FelixLee43/Mechatronic-2023/0713调研报告/Images/麦克纳姆轮.png

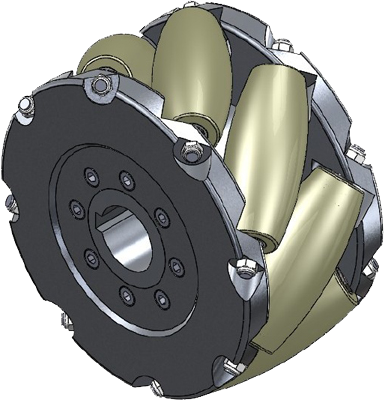
0713调研报告/Images/麦克纳姆轮.png
