FelixLee43/Mechatronic-2023/README.md

# 机电系统设计实践 第8组

> 许瀵译，李昊阳，贺则凡

任务展板：`https://kdocs.cn/l/ckOISye3qsVi`
