FelixLee43/Mechatronic-2023/0713调研报告/Images/绘图.pptx

开始

生成初始种群

计算个体适应度

变异操作

是否满足迭
代终止条件

交叉操作

否

选择操作

是

末代种群

最优个体

结束

## Slide 2

开始

初始化种群

适应度评
估和排序

使用改进轮盘
堵法选择个体

得
到
新
一
代
种
群

使用自适应概率
执行变异操作

是否满足迭
代终止条件

得到最优路径

否

是

结束

## Slide 3

开始

初始化粒子群中各
粒子的位置和速度

计算粒子的适应度值

求出每个粒子的个体最优

求出全部粒子的全局最优

更新粒子的速度和位置

是否满足迭
代终止条件

输出适应度
值最优个体

结束

否

是

## Slide 4

障碍

目标

引力

斥力

小
车

合力
