FelixLee43/Mechatronic-2023/0712课堂展示/Images/1.png

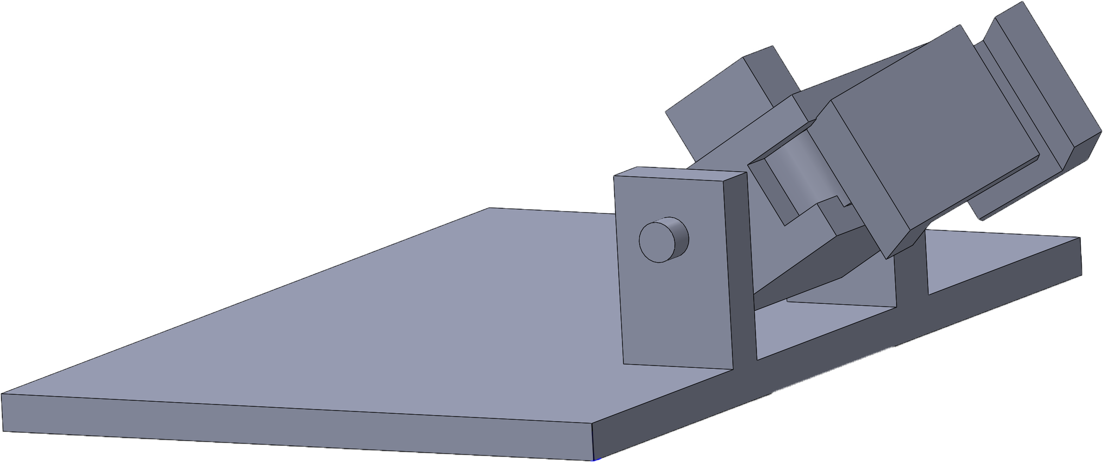
0712课堂展示/Images/1.png
