FelixLee43/Mechatronic-2023/0712课堂展示/Images/2.png

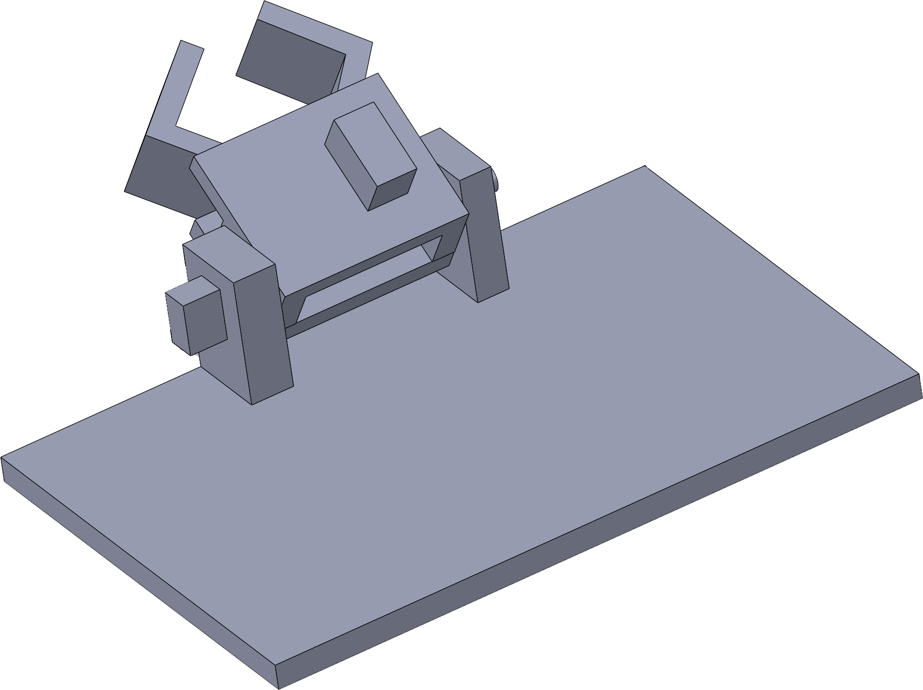
0712课堂展示/Images/2.png
