FelixLee43/Mechatronic-2023/0712课堂展示/Images/DJI Action 2 特写.jpg

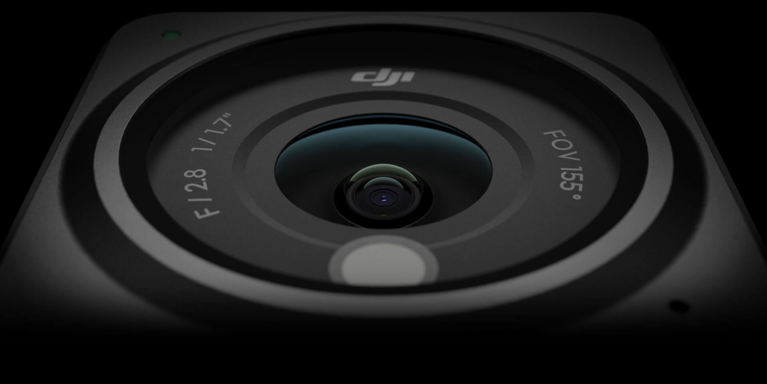
0712课堂展示/Images/DJI Action 2 特写.jpg
