FelixLee43/Mechatronic-2023/0712课堂展示/Images/openmv.png

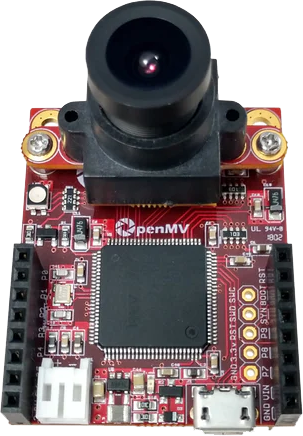
0712课堂展示/Images/openmv.png
