FelixLee43/Mechatronic-2023/机电系统设计实践_张佳悦_2022/作业/第三组智能小车/智能小车3D模型/L298N/L298N Stepper Motor Driver (Red).10.jpg

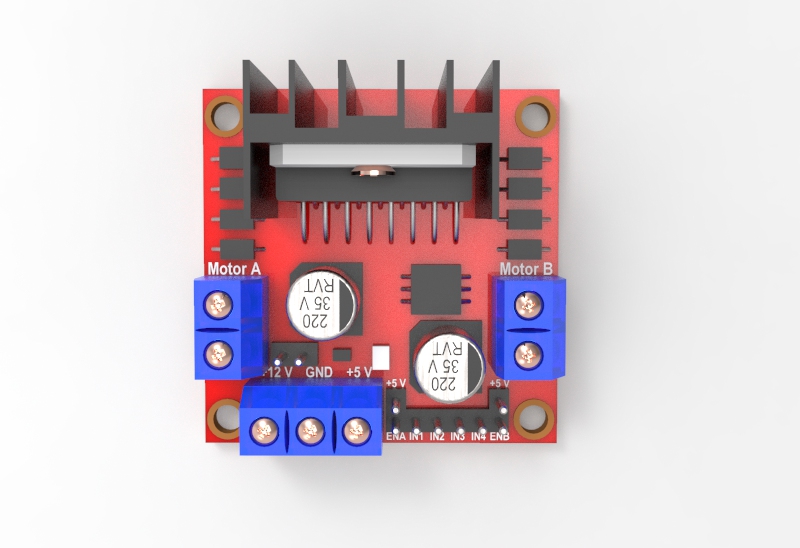
机电系统设计实践_张佳悦_2022/作业/第三组智能小车/智能小车3D模型/L298N/L298N Stepper Motor Driver (Red).10.jpg
