FelixLee43/Mechatronic-2023/机电系统设计实践_张佳悦_2022/作业/第三组智能小车/智能小车3D模型/SG90/Tower Pro 9g Micro Servo SG9 side.JPG

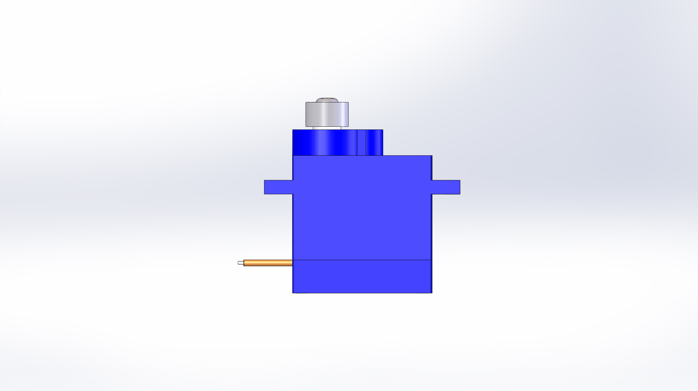
机电系统设计实践_张佳悦_2022/作业/第三组智能小车/智能小车3D模型/SG90/Tower Pro 9g Micro Servo SG9 side.JPG
