FelixLee43/Mechatronic-2023/机电系统设计实践_张佳悦_2022/作业/第三组智能小车/电气原理图（最终）.jpg

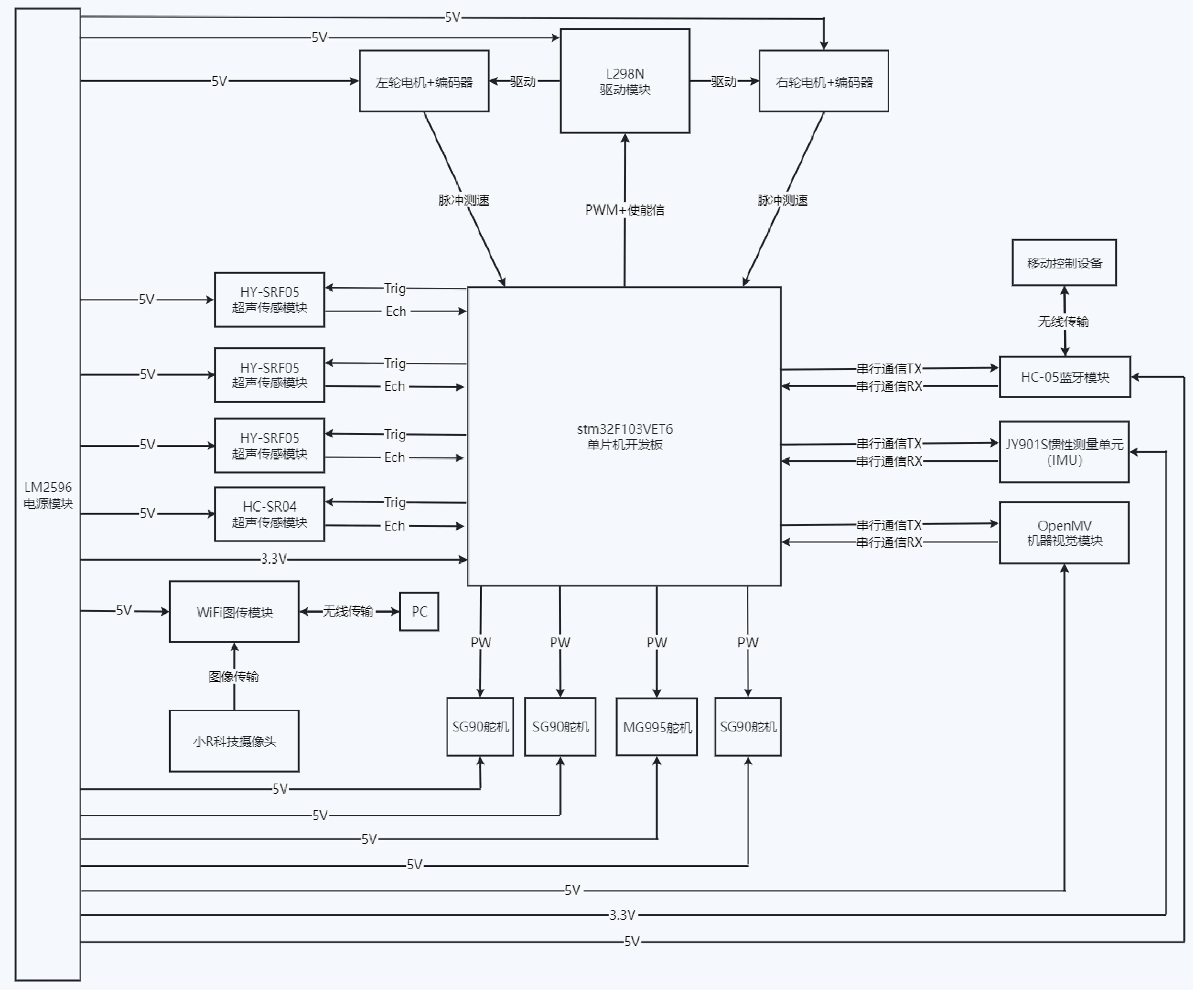
机电系统设计实践_张佳悦_2022/作业/第三组智能小车/电气原理图（最终）.jpg
