FelixLee43/Mechatronic-2023/机电系统设计实践_张佳悦_2022/作业/第三组详细设计/巡线软件.jpg

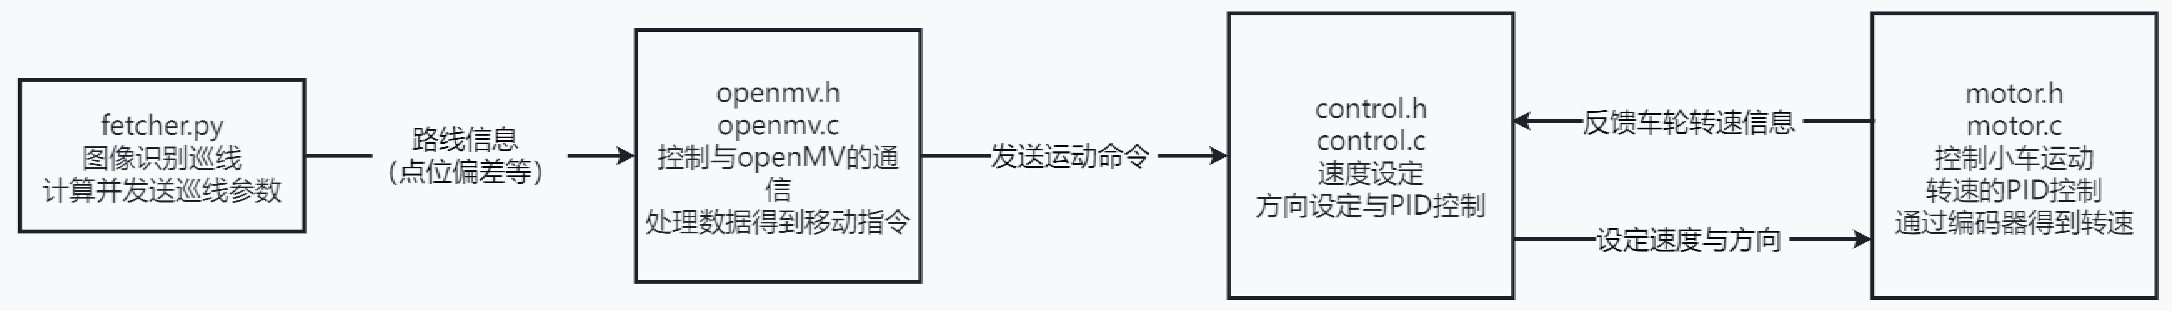
机电系统设计实践_张佳悦_2022/作业/第三组详细设计/巡线软件.jpg
