FelixLee43/Mechatronic-2023/机电系统设计实践_张佳悦_2022/材料清单.xlsx

材料 |  | 采购网址
控制平台 | 树莓派4代B （+外壳，散热片，电源线，风扇，16G储存卡）
 | STM32F103VET6开发板 | https://detail.tmall.com/item.htm?spm=a230r.1.14.64.71247093qWLax0&id=553122064820&ns=1&abbucket=12
传感器 | openMV | https://item.taobao.com/item.htm?id=612497720394&ns=1&abbucket=18
 | 激光雷达 | http://www.alsrobot.com.cn/goods-640.html
 | JY901S九轴IMU磁场加速度陀螺仪大气压强模块 | https://detail.tmall.com/item.htm?id=598203013266&ns=1&abbucket=0&skuId=4169997421172
 | 线性CCD(90度镜头) | https://item.taobao.com/item.htm?id=20749708544&ns=1&abbucket=12 (https://item.taobao.com/item.htm?spm=a230r.1.14.8.614e28fbKapafQ&id=20749708544&ns=1&abbucket=12)
 | HC-05蓝牙模块 | https://detail.tmall.com/item.htm?id=41327338424&rn=f2da8ad3bbef5681af64506ce8cc4ab0&abbucket=9
 | HC-SR04超声模块 | https://detail.tmall.com/item.htm?id=14466195609&ns=1&abbucket=12&skuId=3108214440220
执行器 | MG995 55G金属铜齿轮舵机 | https://item.taobao.com/item.htm?spm=a1z09.2.0.0.hFiM7A&id=530499783252&_u=bk64iil2e64
 | SG90 9G180度舵机 | https://item.taobao.com/item.htm?spm=a1z09.2.0.0.hFiM7A&id=528726113590&_u=bk64iil42c8
 | 直流减速电机带编码器1（12V，280rpm） | https://item.taobao.com/item.htm?id=533000737918&ns=1&abbucket=20 (https://item.taobao.com/item.htm?spm=a230r.1.14.13.466651825vUDDT&id=533000737918&ns=1&abbucket=20)
 | 直流减速电机带编码器2(12V,1:19减速比) | https://item.taobao.com/item.htm?spm=2013.1.w4004-10302371007.16.429c39e911jBcm&id=559699663497
 | L298N电机驱动板模块 | https://detail.tmall.com/item.htm?id=41248562401&ns=1&abbucket=12&skuId=4114388729372
 | ST-Link-V2 | https://detail.tmall.com/item.htm?id=521735720322&rn=fb11b15e9c6066752406e3460974b152&abbucket=9
 | USB转串口 | https://detail.tmall.com/item.htm?id=20601680359&spm=a1z09.2.0.0.UfbUKk&_u=bk64iilb651
 | 软串线 | 配套
车体 | 车轮+支架+联轴器 | 配套直流电机
电池 | 电池组 | 中发采购
 | 电源模块 | https://item.taobao.com/item.htm?_u=42fomaq693ee&id=16606969730
