FelixLee43/Mechatronic-2023/机电系统设计实践_张佳悦_2022/作业/第三组智能小车/智能小车3D模型/MG995/egrane2latonpin.SLDPRT.SLDASM

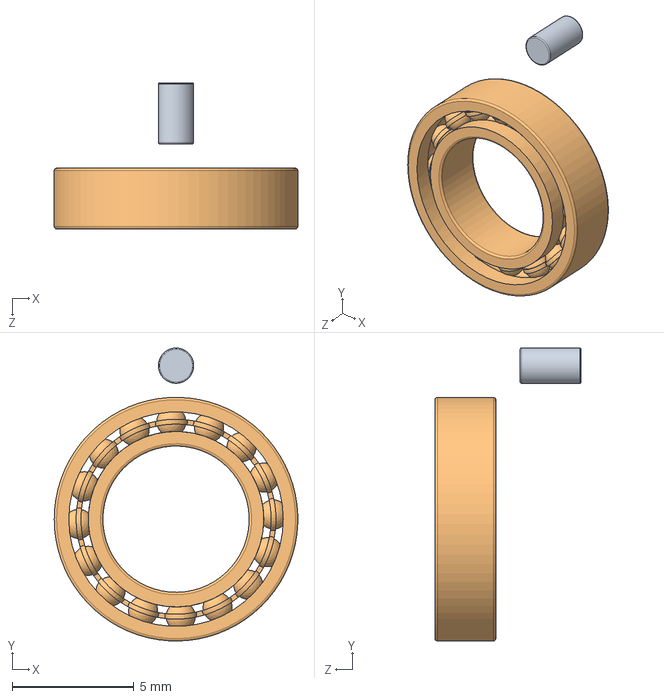
[picture p129: CAD file, 2023-07-10]
机电系统设计实践_张佳悦_2022/作业/第三组智能小车/智能小车3D模型/MG995/egrane2latonpin.SLDPRT.SLDASM
10.00 x 12.0 x 6.00 mm
egrane2latonpin
radial ball bearing_68_am
