FelixLee43/Mechatronic-2023/机电系统设计实践_张佳悦_2022/作业/第三组详细设计/智能小车3D模型/车轮/车轮部分.SLDASM

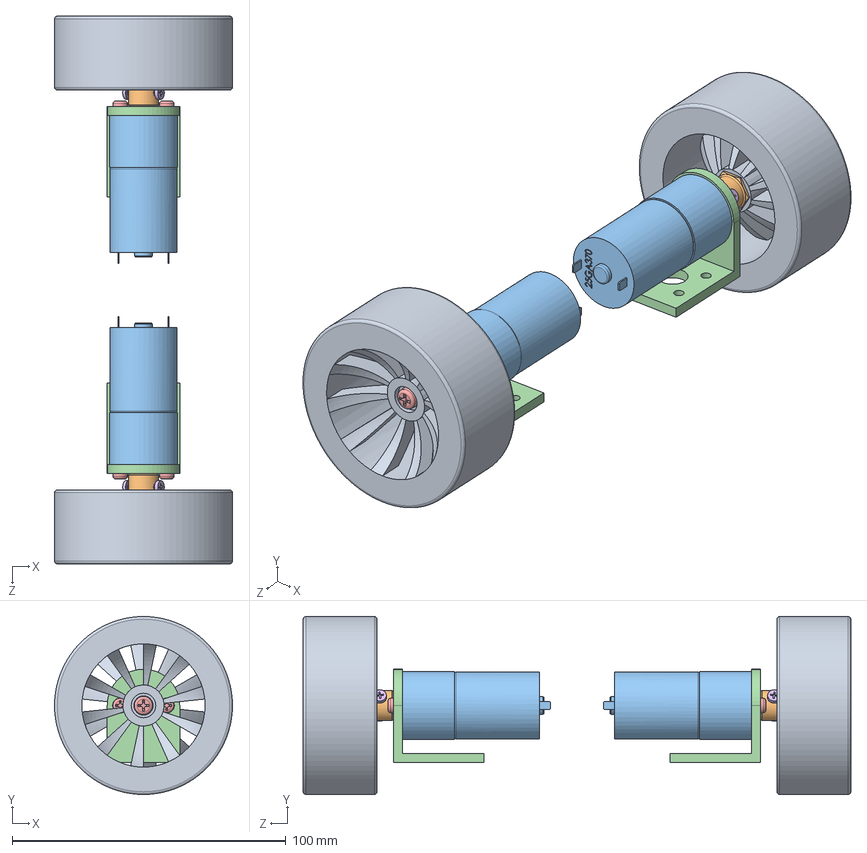
[picture p130: CAD file, 2023-07-10]
机电系统设计实践_张佳悦_2022/作业/第三组详细设计/智能小车3D模型/车轮/车轮部分.SLDASM
65.0 x 65.0 x 200.0 mm
橡胶车轮 x 2
内六角联轴器 x 2
25GA370 x 2
25GA370支撑架 x 2
cross recessed cheese head screws gb x 6
cross recessed cheese head screws type a gb x 4
