FelixLee43/Mechatronic-2023/智能小车/牛眼轮/牛眼轮.SLDASM

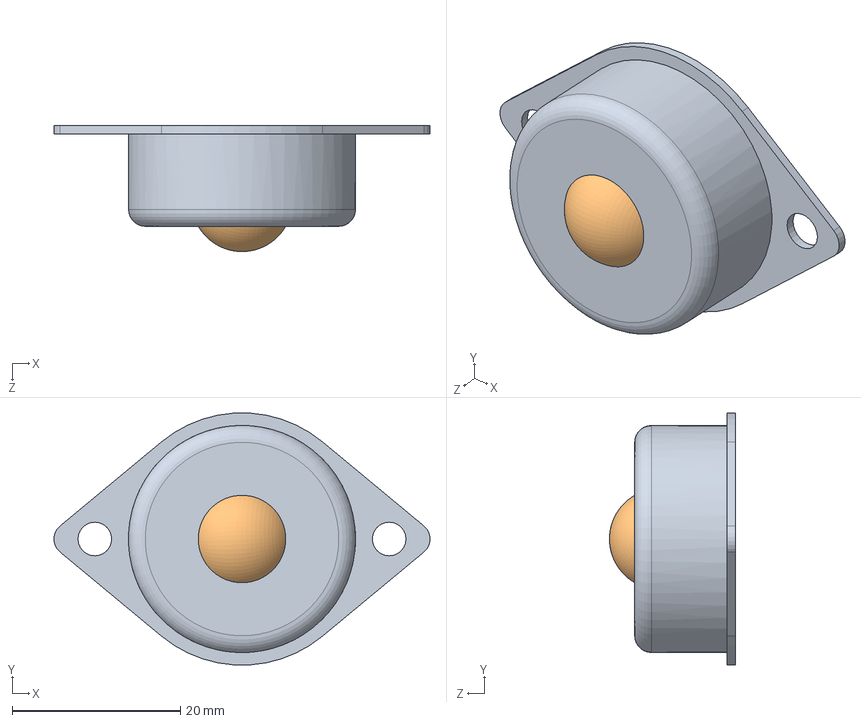
[picture p131: CAD file, 2023-07-15]
智能小车/牛眼轮/牛眼轮.SLDASM
44.7 x 29.9 x 15.0 mm
牛眼轮框
牛眼轮心
