FelixLee43/Mechatronic-2023/机电系统设计实践_张佳悦_2022/作业/第三组详细设计/智能小车3D模型/L298N/L298N.SLDASM

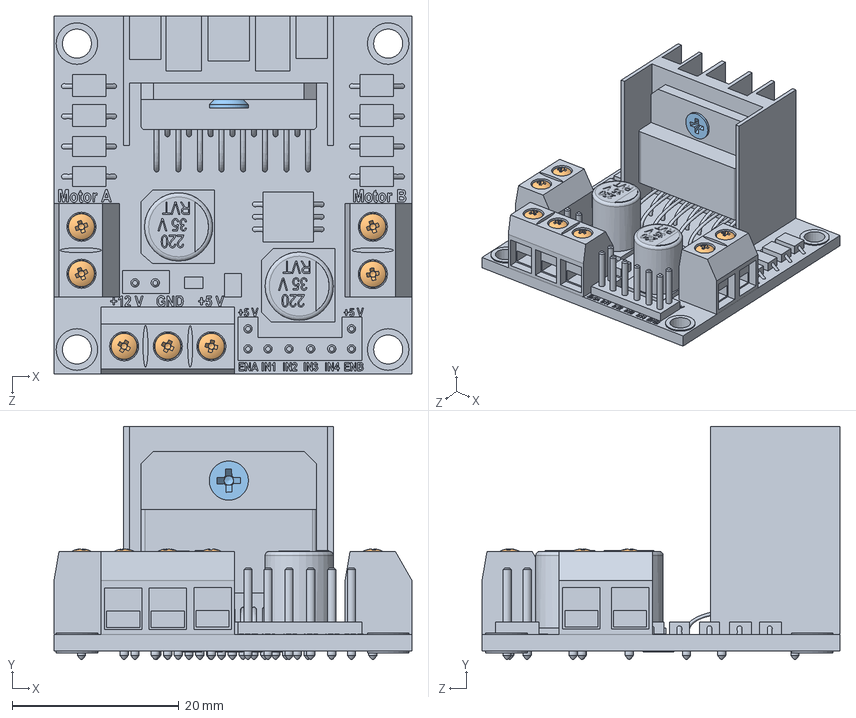
[picture p132: CAD file, 2023-07-10]
机电系统设计实践_张佳悦_2022/作业/第三组详细设计/智能小车3D模型/L298N/L298N.SLDASM
43.0 x 28.0 x 43.0 mm
L298N Stepper Motor Driver (Red)
pan head cross recess screw_iso x 7
countersunk flat head cross recess screw_iso
