FelixLee43/Mechatronic-2023/机电系统设计实践_张佳悦_2022/作业/第三组智能小车/智能小车3D模型/SG90/SG90.SLDASM

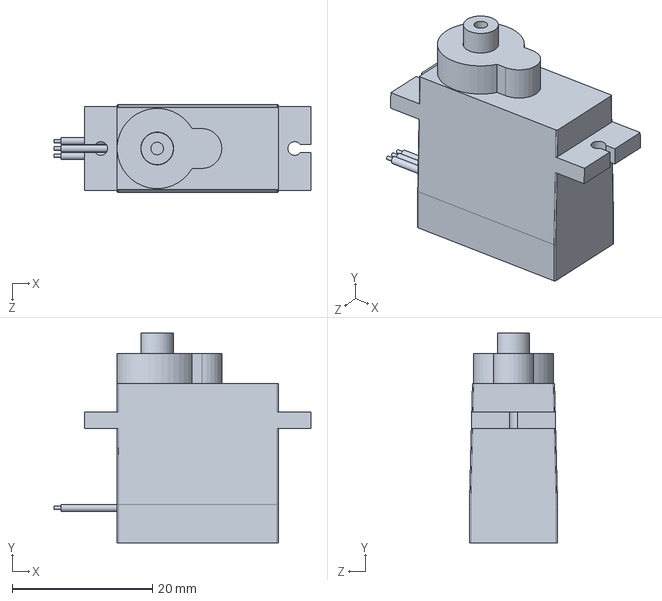
[picture p133: CAD file, 2023-07-10]
机电系统设计实践_张佳悦_2022/作业/第三组智能小车/智能小车3D模型/SG90/SG90.SLDASM
36.7 x 30.0 x 12.6 mm
