FelixLee43/Mechatronic-2023/机电系统设计实践_张佳悦_2022/作业/第三组详细设计/智能小车3D模型/机械臂/机械臂.SLDASM

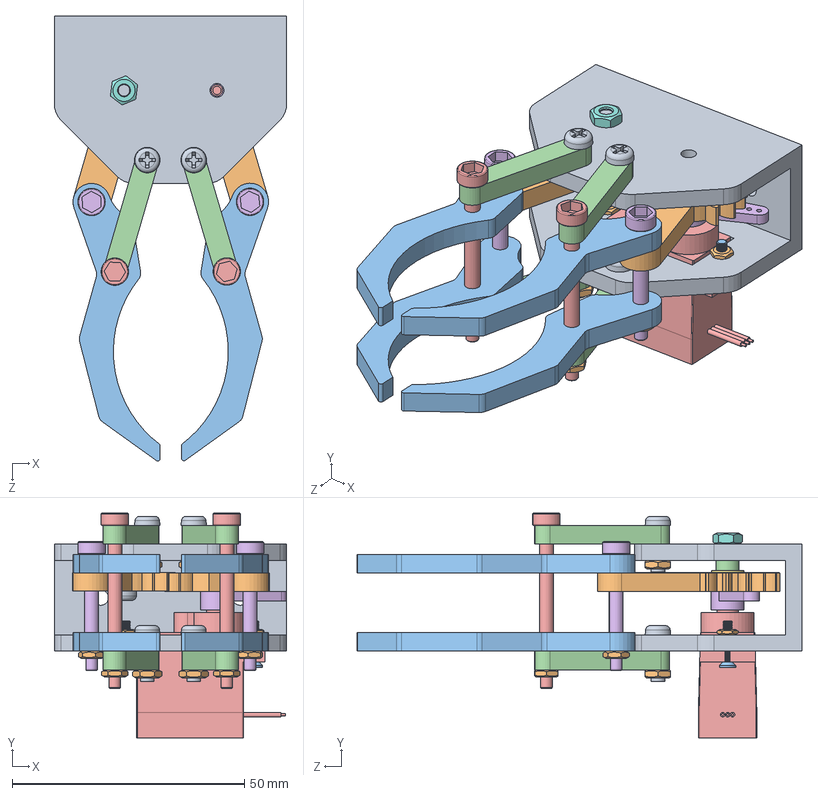
[picture p134: CAD file, 2023-07-10]
机电系统设计实践_张佳悦_2022/作业/第三组详细设计/智能小车3D模型/机械臂/机械臂.SLDASM
50.0 x 48.4 x 95.7 mm
支撑板（改）
齿轮传动杆 x 2
机械手爪（改） x 4
连杆（改） x 4
Tower Pro 9g Micro Servo SG90
SG90 plastic Horn
plain washers--product grade c gb
hex nuts, style 1-grades ab gb
cross recessed cheese head screws gb x 5
hex thin nuts-grades ab-chamfered gb x 10
cross recessed countersunk head screws gb2 x 2
2.1支撑垫片
30限位螺栓 x 2
20限位螺栓 x 2
