FelixLee43/Mechatronic-2023/机电系统设计实践_张佳悦_2022/作业/第三组详细设计/智能小车3D模型/MG995/tapa servorodamiento.SLDPRT.SLDASM

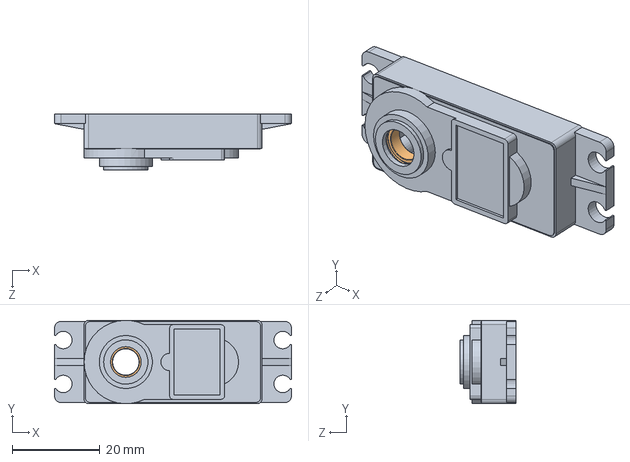
[picture p135: CAD file, 2023-07-10]
机电系统设计实践_张佳悦_2022/作业/第三组详细设计/智能小车3D模型/MG995/tapa servorodamiento.SLDPRT.SLDASM
54.0 x 19.0 x 12.8 mm
tapa servo
radial ball bearing_68_am
