FelixLee43/Mechatronic-2023/机电系统设计实践_张佳悦_2022/作业/第三组智能小车/智能小车3D模型/MG995/egrane4aluminiolaton.SLDPRT.SLDASM

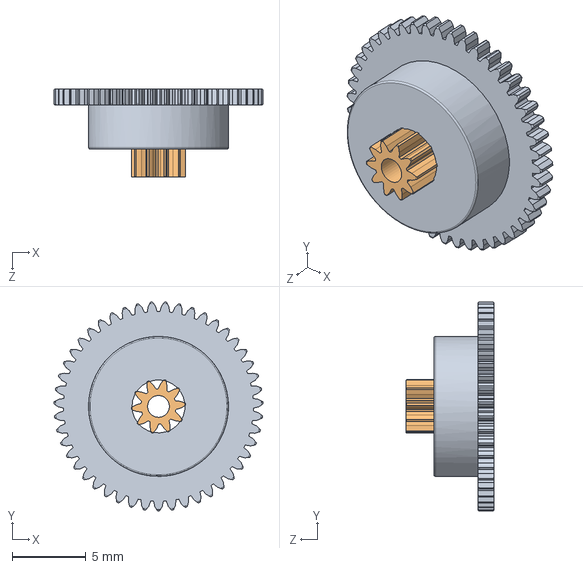
[picture p137: CAD file, 2023-07-10]
机电系统设计实践_张佳悦_2022/作业/第三组智能小车/智能小车3D模型/MG995/egrane4aluminiolaton.SLDPRT.SLDASM
14.2 x 14.2 x 6.00 mm
egrane4laton
egrane4aluminio
