FelixLee43/Mechatronic-2023/机电系统设计实践_张佳悦_2022/作业/第三组智能小车/智能小车3D模型/MG995/MG995.SLDASM

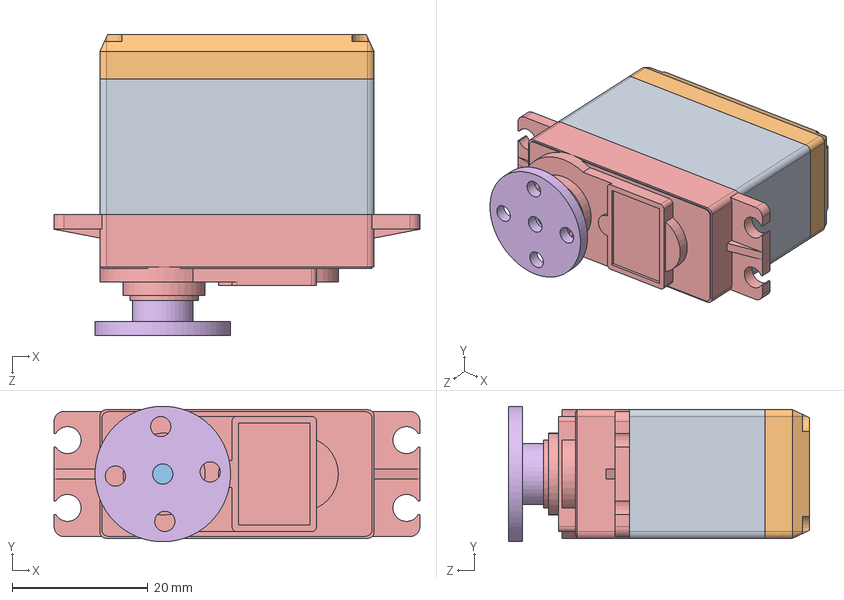
[picture p138: CAD file, 2023-07-10]
机电系统设计实践_张佳悦_2022/作业/第三组智能小车/智能小车3D模型/MG995/MG995.SLDASM
54.0 x 20.0 x 44.3 mm
centroservo
egrane3laton
egrane3aluminio
egrane4laton
egrane4aluminio
engrane2
pincorto
pinlargo
radial ball bearing_68_am x 2
baseservo
otro
egrane2latonpin
tapa servo
Bracket-Horn
