FelixLee43/Mechatronic-2023/机电系统设计实践_张佳悦_2022/作业/第三组详细设计/智能小车3D模型/OpenMV H7/openmv4_ov7725.SLDASM

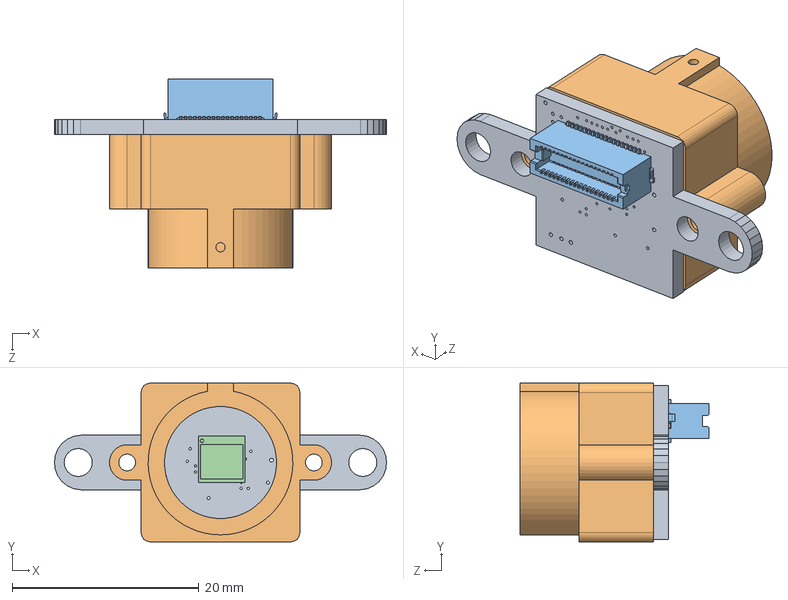
[picture p139: CAD file, 2023-07-10]
机电系统设计实践_张佳悦_2022/作业/第三组详细设计/智能小车3D模型/OpenMV H7/openmv4_ov7725.SLDASM
35.6 x 17.0 x 20.2 mm
ov7725
mount_lens
DF1236
CSP2-28
