FelixLee43/Mechatronic-2023/机电系统设计实践_张佳悦_2022/作业/第三组智能小车/智能小车3D模型/OpenMV H7/OpenMV H7.SLDASM

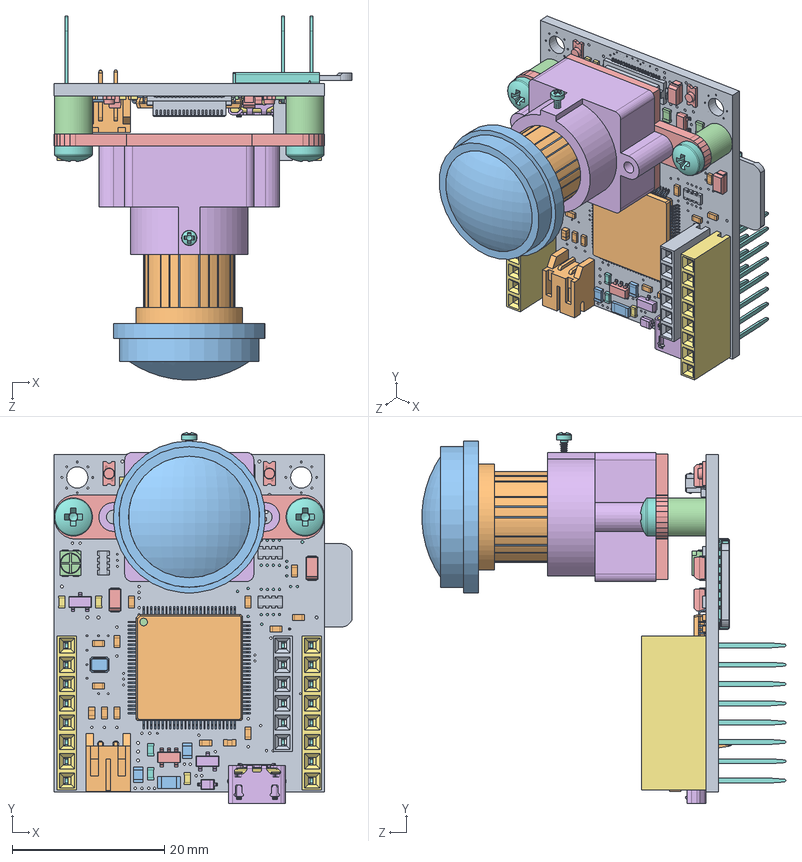
[picture p140: CAD file, 2023-07-10]
机电系统设计实践_张佳悦_2022/作业/第三组智能小车/智能小车3D模型/OpenMV H7/OpenMV H7.SLDASM
39.2 x 48.8 x 47.9 mm
base
C0603K_C0603K x 13
C0805K_C0805K x 2
cap3216h160 x 3
SOD323_BAT54HT1G
960240-6202-AR Body8 x 2
960240-6202-AR Pin Long x 22
960240-6202-AR Body6
Capacitor 0603 x 2
LED SMD RGB
LED 1206 IR x 2
SOT 23 x 2
Resistor 0603 x 5
R0603_SJR x 2
EXBV8V x 3
User Library-LQFP100-3_case
User Library-LQFP100-3_pin x 100
User Library-LQFP100-3_circle
SOT 23-5 x 2
UJ2-MIBH2-4-SMT_01
UJ2-MIBH2-4-SMT_02
1040310811_USD1040310811
DF12-36DS-0.5V
S2B-PH-K-S(LF)(SN)
Crystal-SM2520-4
Standoff metal 5x2.5mm x 2
ov7725
mount_lens
CSP2-28
pan head cross recess screw_iso x 3
microsd card
LENS_Standard
LENS_Wide
