FelixLee43/Mechatronic-2023/机电系统设计实践_张佳悦_2022/作业/第三组详细设计/智能小车3D模型/OpenMV H7/User Library-LQFP100-3.sldasm

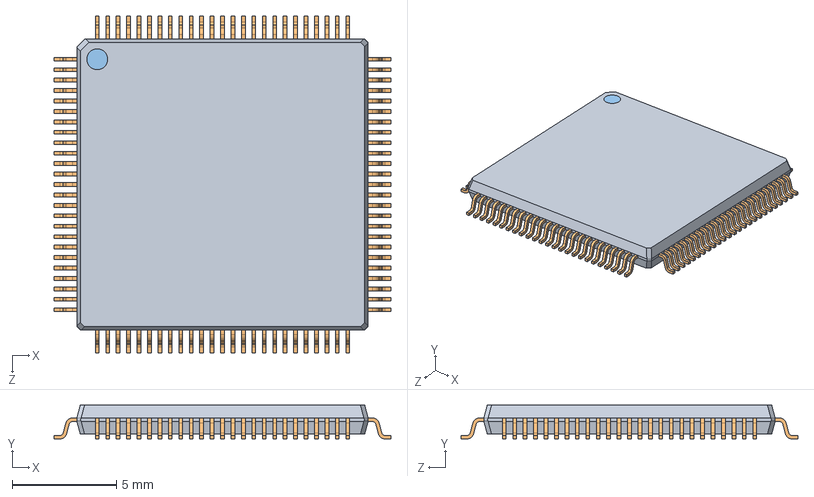
[picture p142: CAD file, 2023-07-10]
机电系统设计实践_张佳悦_2022/作业/第三组详细设计/智能小车3D模型/OpenMV H7/User Library-LQFP100-3.sldasm
16.1 x 1.63 x 16.1 mm
User Library-LQFP100-3_case
User Library-LQFP100-3_pin x 100
User Library-LQFP100-3_circle
