FelixLee43/Mechatronic-2023/机电系统设计实践_张佳悦_2022/作业/第三组详细设计/智能小车3D模型/OpenMV H7/UJ2-MIBH2-4-SMT.SLDASM

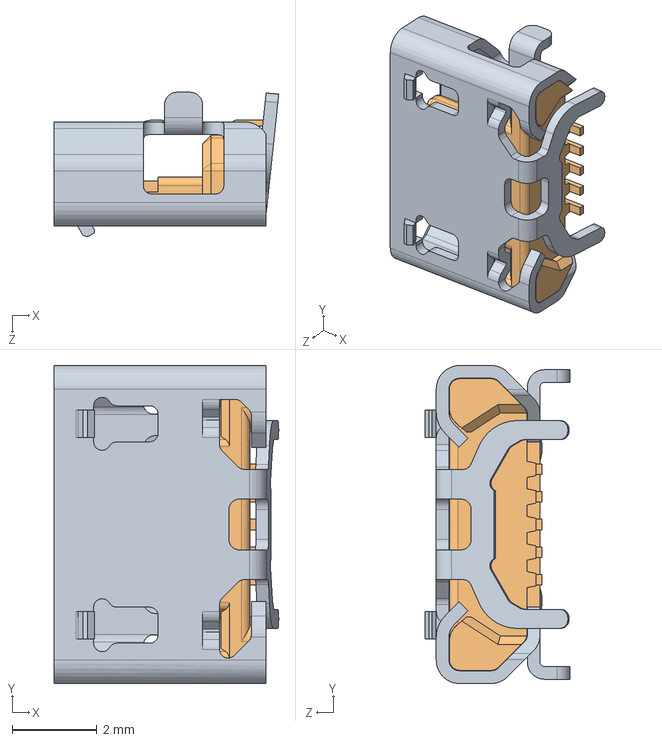
[picture p143: CAD file, 2023-07-10]
机电系统设计实践_张佳悦_2022/作业/第三组详细设计/智能小车3D模型/OpenMV H7/UJ2-MIBH2-4-SMT.SLDASM
5.29 x 7.50 x 3.41 mm
UJ2-MIBH2-4-SMT_01
UJ2-MIBH2-4-SMT_02
