FelixLee43/Mechatronic-2023/智能小车/二楼/二楼.SLDPRT

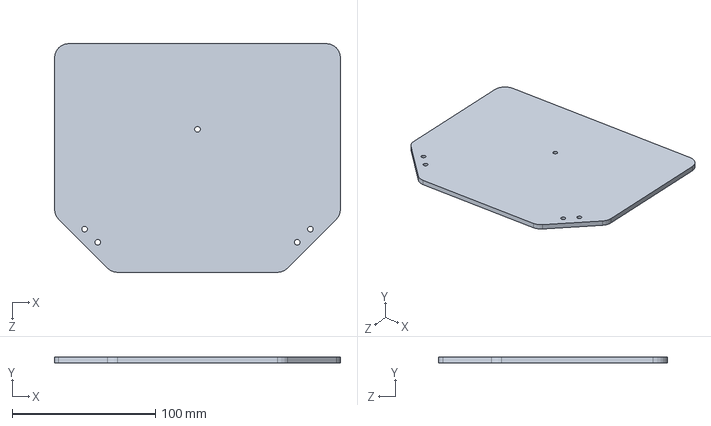
[picture p144: CAD file, 2023-07-15]
智能小车/二楼/二楼.SLDPRT
200.0 x 4.00 x 160.0 mm
