FelixLee43/Mechatronic-2023/智能小车/底板/底板.SLDPRT

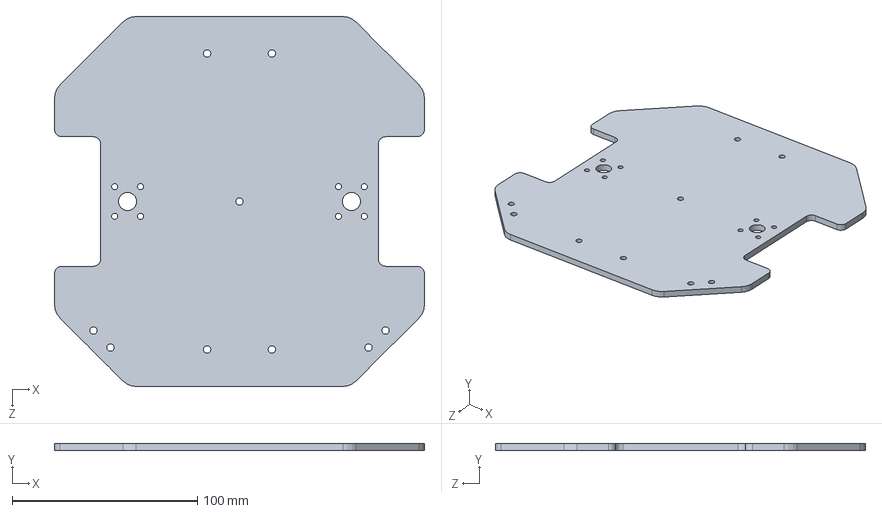
[picture p145: CAD file, 2023-07-15]
智能小车/底板/底板.SLDPRT
200.0 x 4.00 x 200.0 mm
