FelixLee43/Mechatronic-2023/智能小车/抓手/抓手齿轮盒.SLDPRT

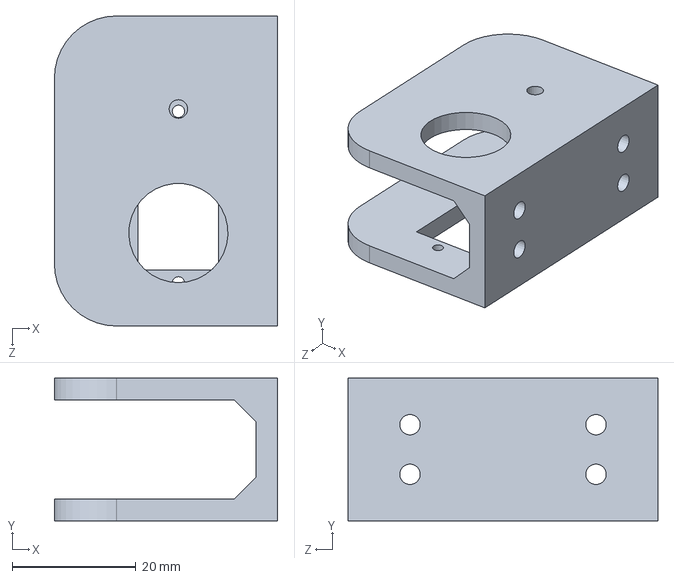
[picture p146: CAD file, 2023-07-15]
智能小车/抓手/抓手齿轮盒.SLDPRT
36.0 x 23.0 x 50.0 mm
