FelixLee43/Mechatronic-2023/智能小车/普通轮/电机.SLDPRT

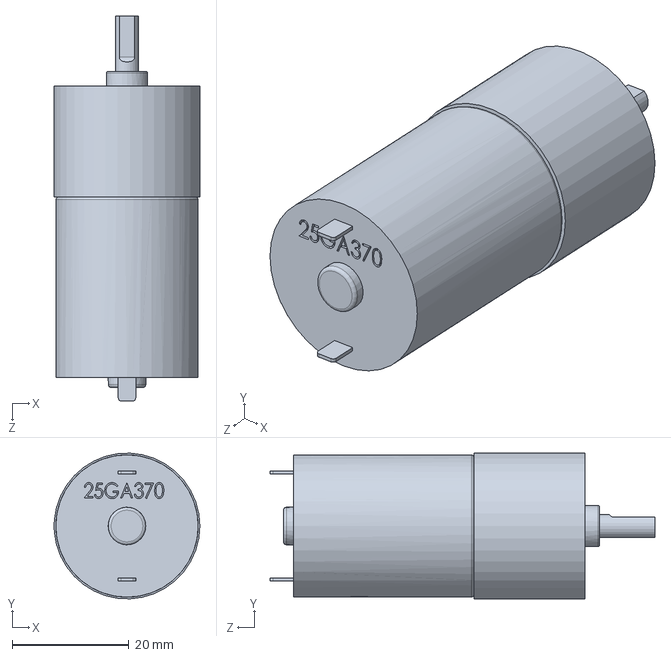
[picture p147: CAD file, 2023-07-15]
智能小车/普通轮/电机.SLDPRT
25.0 x 25.0 x 66.0 mm
