FelixLee43/Mechatronic-2023/智能小车/牛眼轮/牛眼轮心.SLDPRT

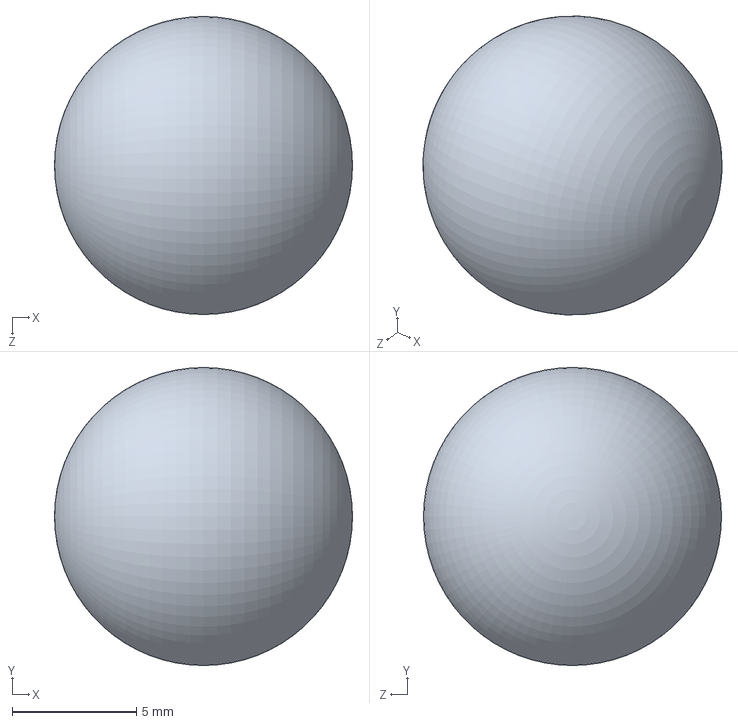
[picture p148: CAD file, 2023-07-15]
智能小车/牛眼轮/牛眼轮心.SLDPRT
12.0 x 12.0 x 12.0 mm
