FelixLee43/Mechatronic-2023/智能小车/超声/超声波探测器.SLDPRT

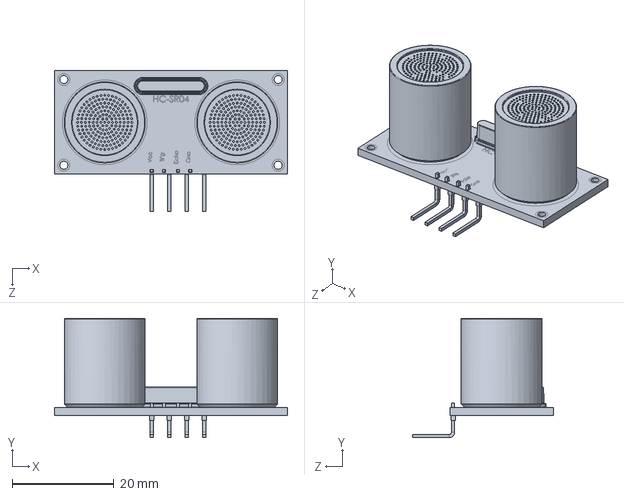
[picture p149: CAD file, 2023-07-15]
智能小车/超声/超声波探测器.SLDPRT
45.7 x 23.4 x 27.6 mm
