FelixLee43/Mechatronic-2023/机电系统设计实践_张佳悦_2022/作业/第三组智能小车/智能小车3D模型/OpenMV H7/EXBV8V.SLDPRT

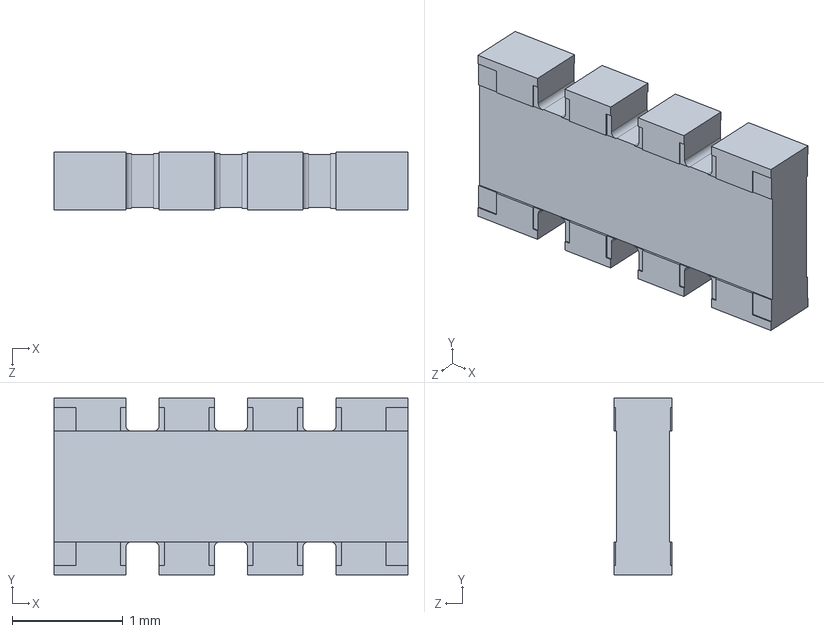
[picture p151: CAD file, 2023-07-10]
机电系统设计实践_张佳悦_2022/作业/第三组智能小车/智能小车3D模型/OpenMV H7/EXBV8V.SLDPRT
3.20 x 1.60 x 0.52 mm
