FelixLee43/Mechatronic-2023/机电系统设计实践_张佳悦_2022/作业/第三组智能小车/智能小车3D模型/二层三层连接件3.SLDPRT

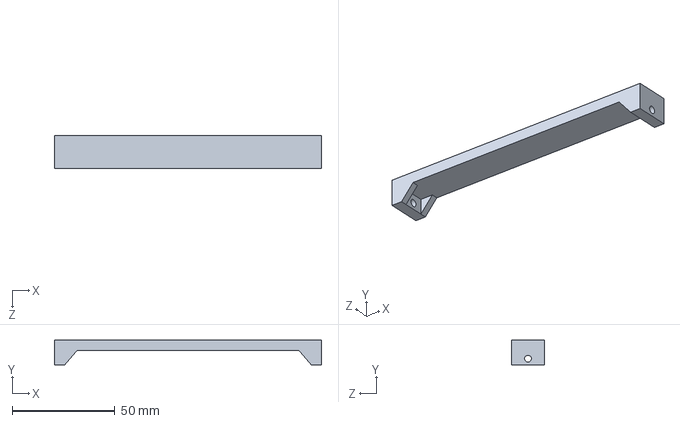
[picture p152: CAD file, 2023-07-10]
机电系统设计实践_张佳悦_2022/作业/第三组智能小车/智能小车3D模型/二层三层连接件3.SLDPRT
130.0 x 12.0 x 16.0 mm
