FelixLee43/Mechatronic-2023/机电系统设计实践_张佳悦_2022/作业/第三组智能小车/智能小车3D模型/机械臂/机械手爪（改）.SLDPRT

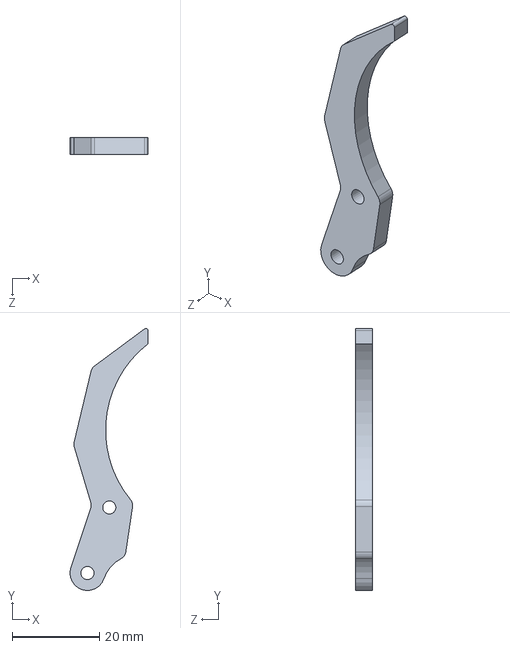
[picture p153: CAD file, 2023-07-10]
机电系统设计实践_张佳悦_2022/作业/第三组智能小车/智能小车3D模型/机械臂/机械手爪（改）.SLDPRT
17.8 x 59.9 x 4.00 mm
