FelixLee43/Mechatronic-2023/机电系统设计实践_张佳悦_2022/作业/第三组智能小车/智能小车3D模型/车轮/25GA370支撑架.SLDPRT

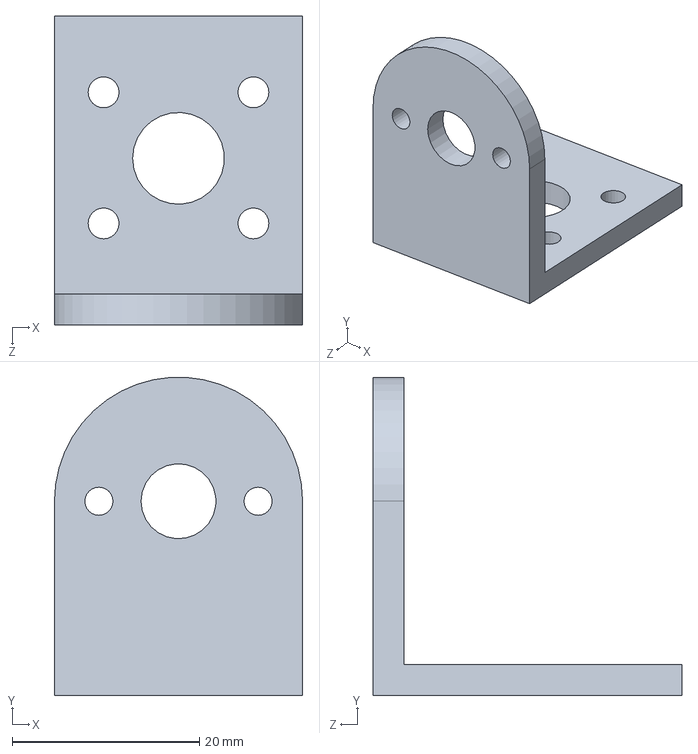
[picture p154: CAD file, 2023-07-10]
机电系统设计实践_张佳悦_2022/作业/第三组智能小车/智能小车3D模型/车轮/25GA370支撑架.SLDPRT
26.5 x 34.0 x 33.0 mm
