FelixLee43/Mechatronic-2023/机电系统设计实践_张佳悦_2022/作业/第三组详细设计/智能小车3D模型/HC-SR04支撑架（右前）新.SLDPRT

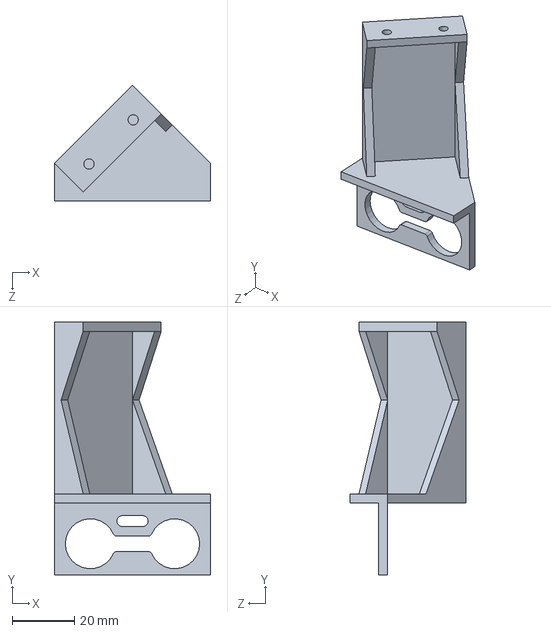
[picture p155: CAD file, 2023-07-10]
机电系统设计实践_张佳悦_2022/作业/第三组详细设计/智能小车3D模型/HC-SR04支撑架（右前）新.SLDPRT
50.0 x 81.0 x 37.0 mm
