FelixLee43/Mechatronic-2023/机电系统设计实践_张佳悦_2022/作业/第三组详细设计/智能小车3D模型/MG995/egrane3laton.SLDPRT

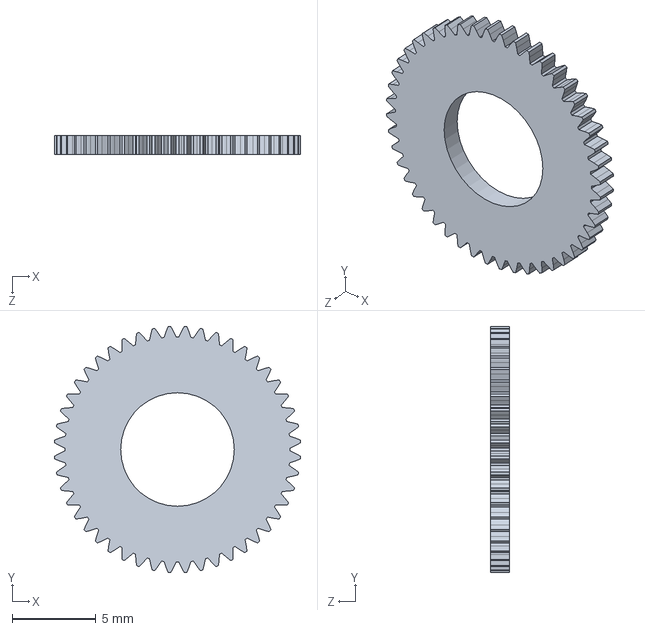
[picture p156: CAD file, 2023-07-10]
机电系统设计实践_张佳悦_2022/作业/第三组详细设计/智能小车3D模型/MG995/egrane3laton.SLDPRT
14.7 x 14.7 x 1.15 mm
