FelixLee43/Mechatronic-2023/智能小车/STM32单片机.SLDPRT

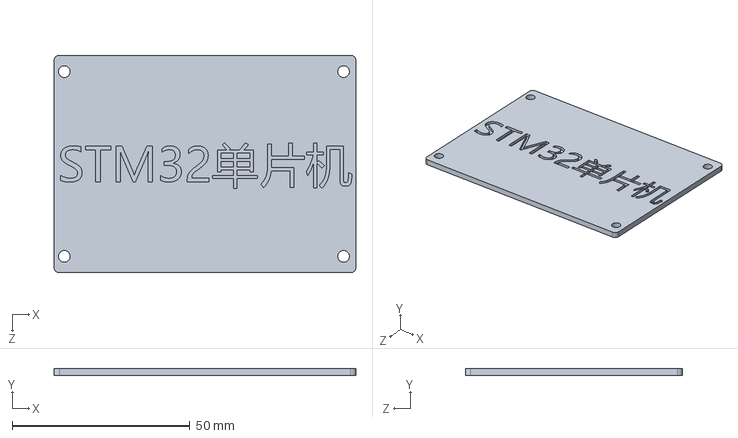
[picture p158: CAD file, 2023-07-15]
智能小车/STM32单片机.SLDPRT
85.0 x 2.00 x 61.2 mm
