FelixLee43/Mechatronic-2023/智能小车/二楼/二楼支撑柱.SLDPRT

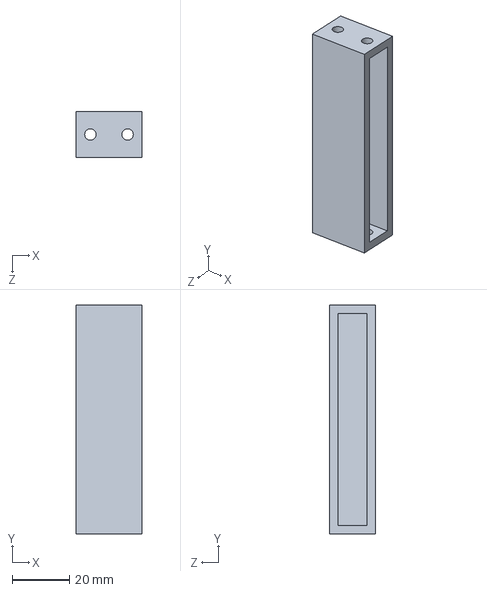
[picture p159: CAD file, 2023-07-15]
智能小车/二楼/二楼支撑柱.SLDPRT
23.0 x 80.0 x 16.0 mm
