FelixLee43/Mechatronic-2023/智能小车/抓手/俯仰部分右固定座.SLDPRT

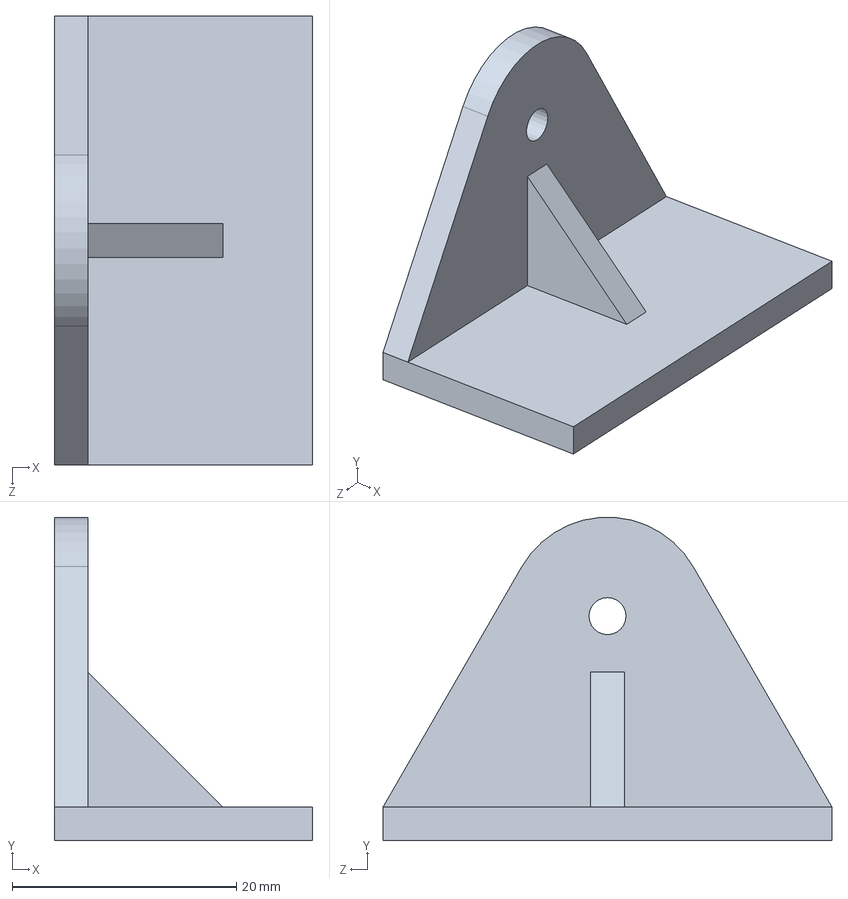
[picture p160: CAD file, 2023-07-15]
智能小车/抓手/俯仰部分右固定座.SLDPRT
23.0 x 28.8 x 40.0 mm
