FelixLee43/Mechatronic-2023/智能小车/超声/超声波探测器支架.SLDPRT

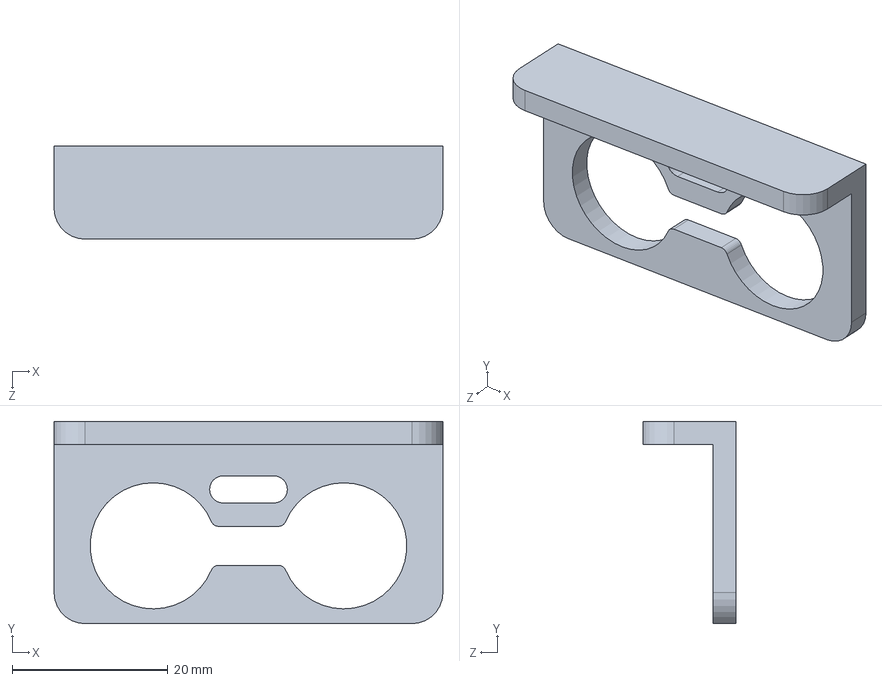
[picture p161: CAD file, 2023-07-15]
智能小车/超声/超声波探测器支架.SLDPRT
50.0 x 26.0 x 12.0 mm
