FelixLee43/Mechatronic-2023/机电系统设计实践_张佳悦_2022/作业/第三组智能小车/智能小车3D模型/MG995/Bracket-Horn.SLDPRT

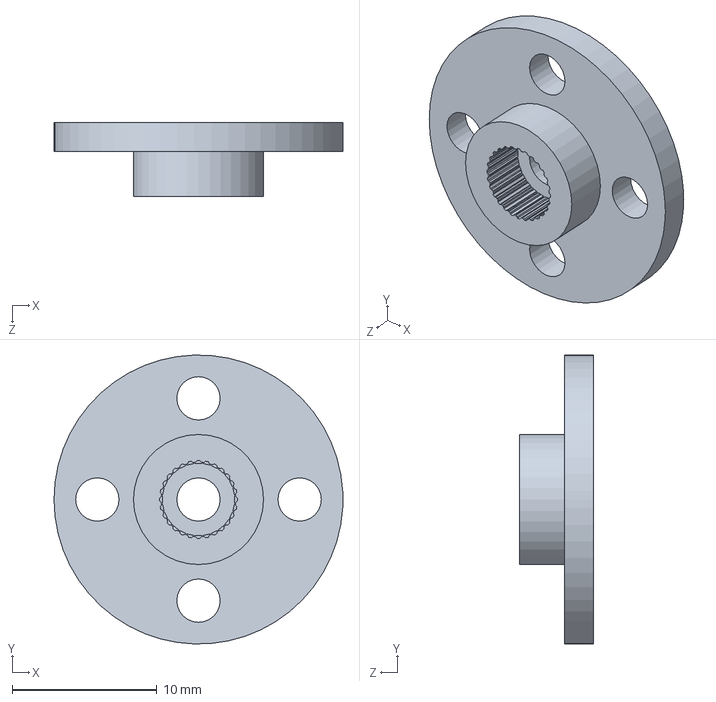
[picture p162: CAD file, 2023-07-10]
机电系统设计实践_张佳悦_2022/作业/第三组智能小车/智能小车3D模型/MG995/Bracket-Horn.SLDPRT
20.0 x 20.0 x 5.10 mm
