FelixLee43/Mechatronic-2023/机电系统设计实践_张佳悦_2022/作业/第三组智能小车/智能小车3D模型/SG90/SG90 plastic Horn.SLDPRT

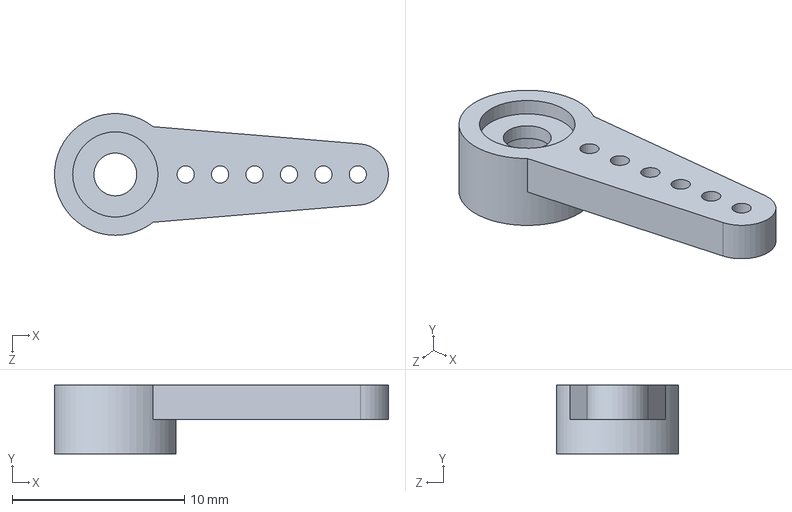
[picture p163: CAD file, 2023-07-10]
机电系统设计实践_张佳悦_2022/作业/第三组智能小车/智能小车3D模型/SG90/SG90 plastic Horn.SLDPRT
19.4 x 4.00 x 7.06 mm
