FelixLee43/Mechatronic-2023/机电系统设计实践_张佳悦_2022/作业/第三组详细设计/智能小车3D模型/OpenMV H7/DF12-36DS-0.5V.SLDPRT

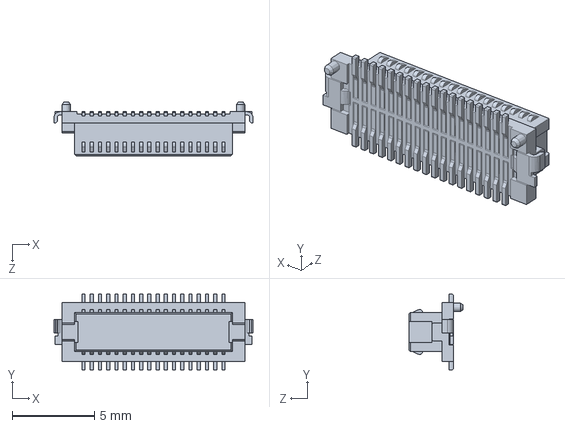
[picture p165: CAD file, 2023-07-10]
机电系统设计实践_张佳悦_2022/作业/第三组详细设计/智能小车3D模型/OpenMV H7/DF12-36DS-0.5V.SLDPRT
12.1 x 4.60 x 3.30 mm
