FelixLee43/Mechatronic-2023/机电系统设计实践_张佳悦_2022/作业/第三组详细设计/智能小车3D模型/一层二层连接件.SLDPRT

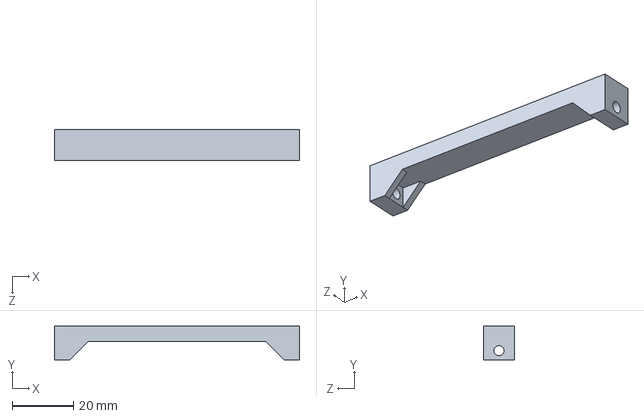
[picture p166: CAD file, 2023-07-10]
机电系统设计实践_张佳悦_2022/作业/第三组详细设计/智能小车3D模型/一层二层连接件.SLDPRT
80.0 x 11.0 x 10.0 mm
