FelixLee43/Mechatronic-2023/机电系统设计实践_张佳悦_2022/作业/第三组详细设计/智能小车3D模型/机械臂/20限位螺栓.SLDPRT

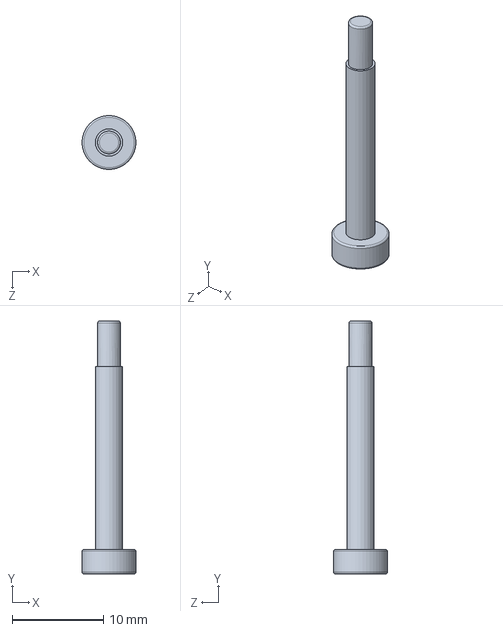
[picture p167: CAD file, 2023-07-10]
机电系统设计实践_张佳悦_2022/作业/第三组详细设计/智能小车3D模型/机械臂/20限位螺栓.SLDPRT
5.89 x 27.7 x 5.90 mm
