FelixLee43/Mechatronic-2023/机电系统设计实践_张佳悦_2022/作业/第三组详细设计/智能小车3D模型/车轮/内六角联轴器.SLDPRT

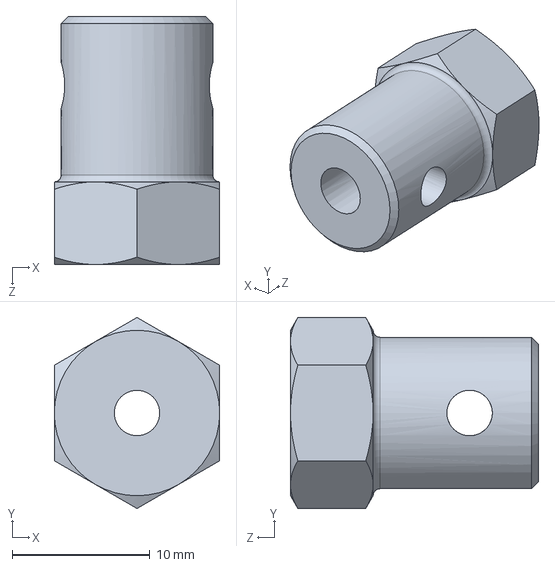
[picture p168: CAD file, 2023-07-10]
机电系统设计实践_张佳悦_2022/作业/第三组详细设计/智能小车3D模型/车轮/内六角联轴器.SLDPRT
12.0 x 13.9 x 18.0 mm
