FelixLee43/Mechatronic-2023/智能小车/抓手/俯仰部分.SLDPRT

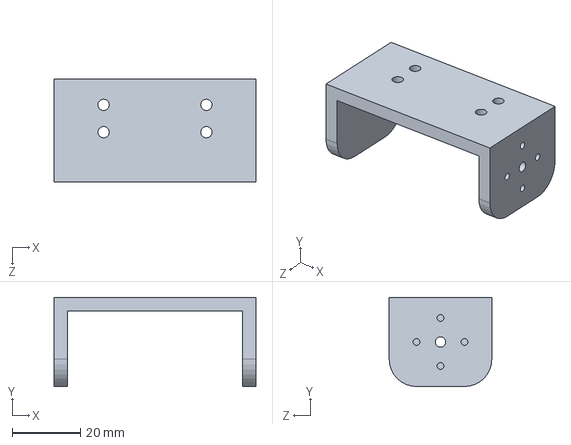
[picture p169: CAD file, 2023-07-15]
智能小车/抓手/俯仰部分.SLDPRT
59.0 x 26.0 x 30.0 mm
