FelixLee43/Mechatronic-2023/智能小车/普通轮/普通轮.SLDPRT

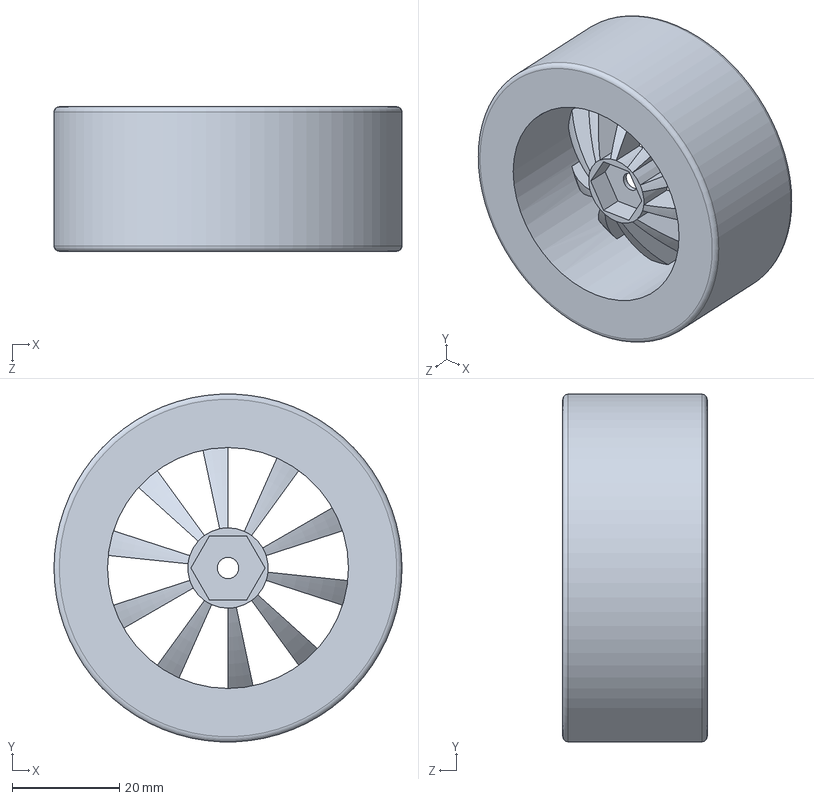
[picture p170: CAD file, 2023-07-15]
智能小车/普通轮/普通轮.SLDPRT
65.0 x 64.9 x 27.0 mm
