FelixLee43/Mechatronic-2023/智能小车/牛眼轮/牛眼轮框.SLDPRT

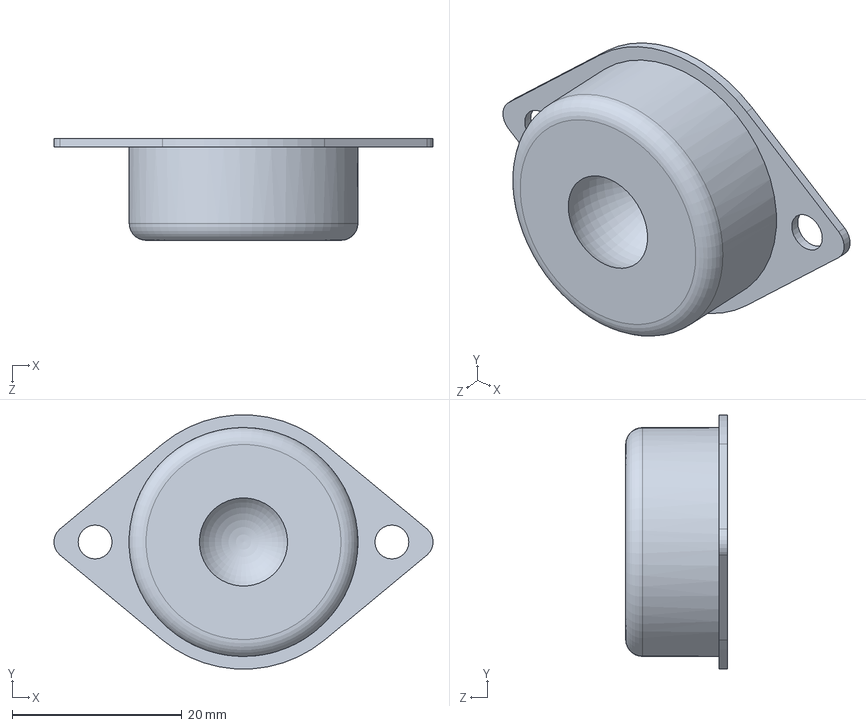
[picture p171: CAD file, 2023-07-15]
智能小车/牛眼轮/牛眼轮框.SLDPRT
44.7 x 29.9 x 12.0 mm
