FelixLee43/Mechatronic-2023/机电系统设计实践_张佳悦_2022/作业/第三组智能小车/智能小车3D模型/摄像头支撑架（改）.SLDPRT

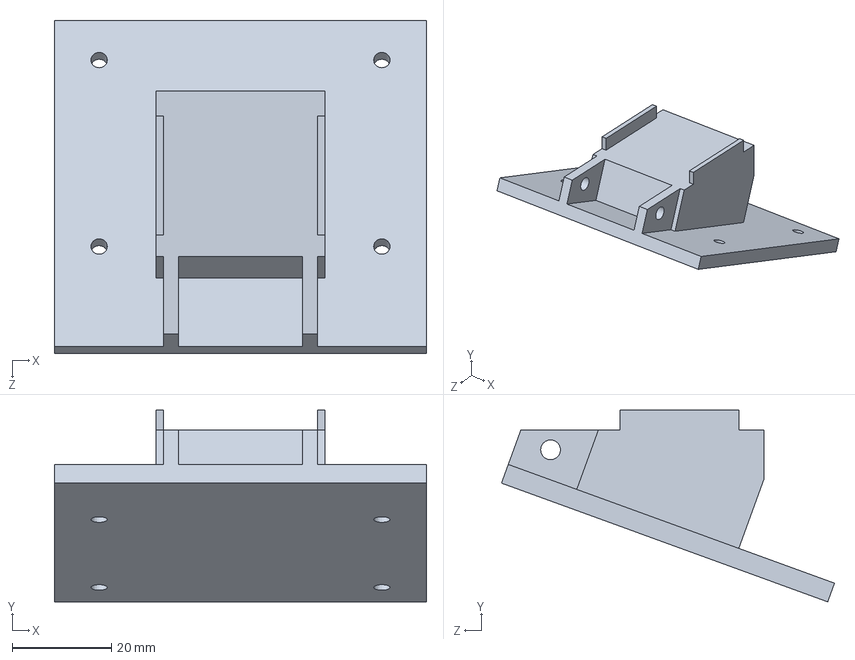
[picture p174: CAD file, 2023-07-10]
机电系统设计实践_张佳悦_2022/作业/第三组智能小车/智能小车3D模型/摄像头支撑架（改）.SLDPRT
75.0 x 38.7 x 67.1 mm
