FelixLee43/Mechatronic-2023/机电系统设计实践_张佳悦_2022/作业/第三组智能小车/智能小车3D模型/机械臂/2.1支撑垫片.SLDPRT

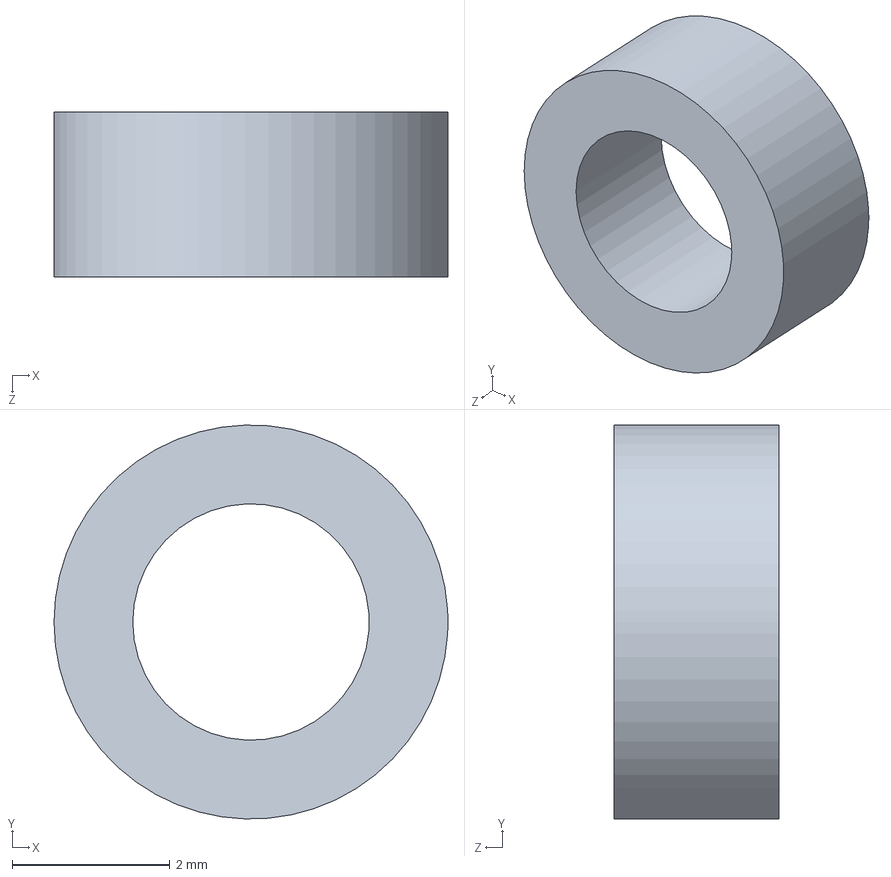
[picture p175: CAD file, 2023-07-10]
机电系统设计实践_张佳悦_2022/作业/第三组智能小车/智能小车3D模型/机械臂/2.1支撑垫片.SLDPRT
5.00 x 5.00 x 2.10 mm
