FelixLee43/Mechatronic-2023/机电系统设计实践_张佳悦_2022/作业/第三组详细设计/智能小车3D模型/OpenMV H7/Resistor 0603.SLDPRT

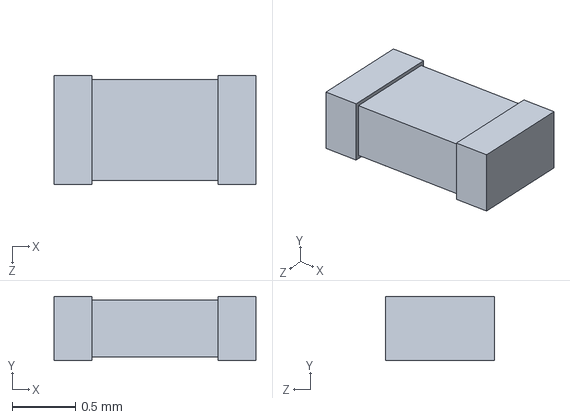
[picture p177: CAD file, 2023-07-10]
机电系统设计实践_张佳悦_2022/作业/第三组详细设计/智能小车3D模型/OpenMV H7/Resistor 0603.SLDPRT
1.60 x 0.51 x 0.86 mm
