FelixLee43/Mechatronic-2023/智能小车/抓手/俯仰部分左固定座.SLDPRT

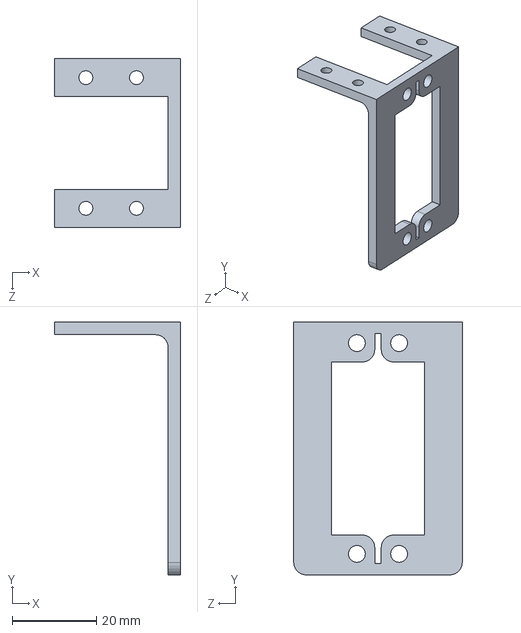
[picture p179: CAD file, 2023-07-15]
智能小车/抓手/俯仰部分左固定座.SLDPRT
30.0 x 60.0 x 40.0 mm
