FelixLee43/Mechatronic-2023/机电系统设计实践_张佳悦_2022/作业/第三组智能小车/智能小车3D模型/MTK7620NWIFI模块.SLDPRT

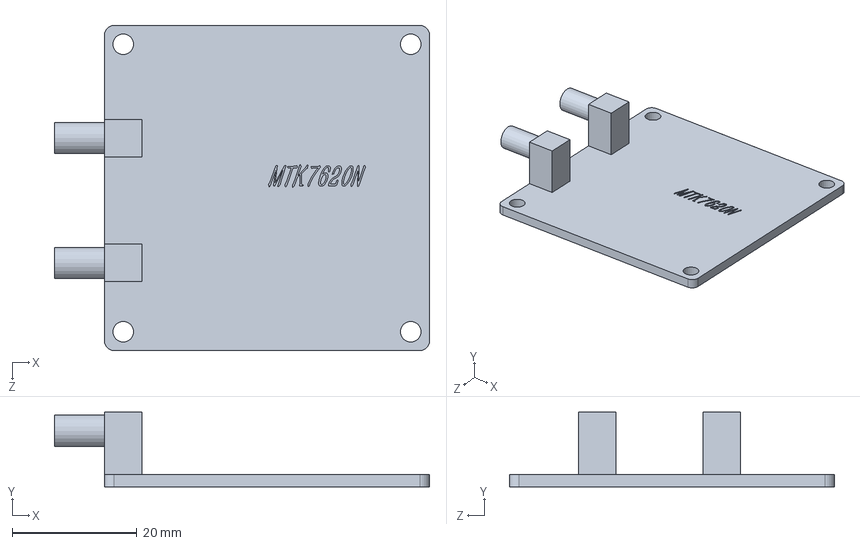
[picture p181: CAD file, 2023-07-10]
机电系统设计实践_张佳悦_2022/作业/第三组智能小车/智能小车3D模型/MTK7620NWIFI模块.SLDPRT
60.0 x 12.0 x 52.0 mm
