FelixLee43/Mechatronic-2023/机电系统设计实践_张佳悦_2022/作业/第三组智能小车/智能小车3D模型/机械臂/齿轮传动杆.SLDPRT

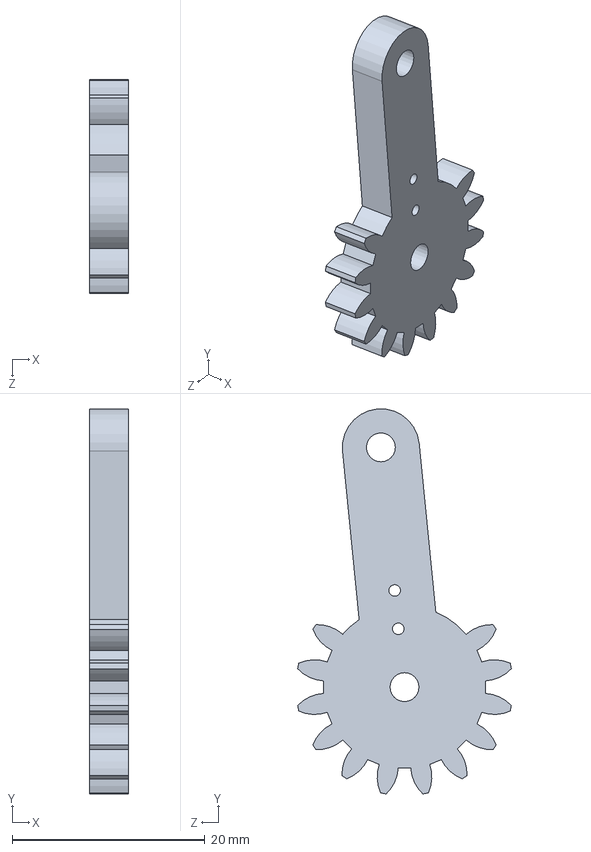
[picture p183: CAD file, 2023-07-10]
机电系统设计实践_张佳悦_2022/作业/第三组智能小车/智能小车3D模型/机械臂/齿轮传动杆.SLDPRT
4.00 x 39.9 x 22.2 mm
