FelixLee43/Mechatronic-2023/机电系统设计实践_张佳悦_2022/作业/第三组智能小车/智能小车3D模型/MG995/tapa servo.SLDPRT

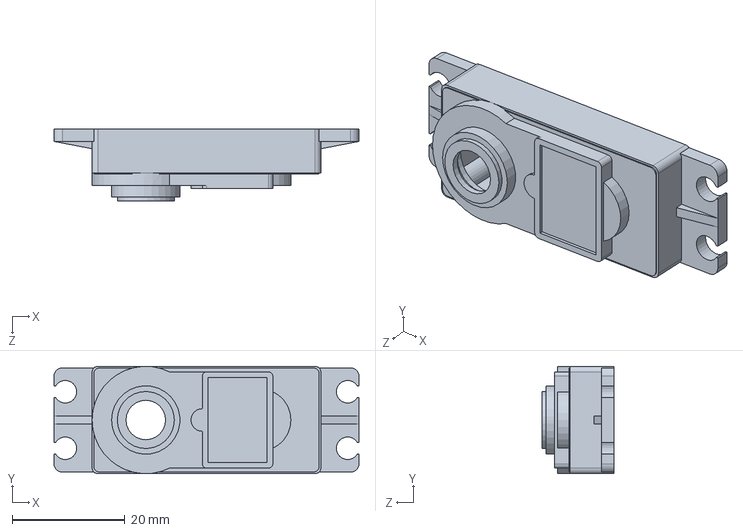
[picture p185: CAD file, 2023-07-10]
机电系统设计实践_张佳悦_2022/作业/第三组智能小车/智能小车3D模型/MG995/tapa servo.SLDPRT
54.0 x 19.0 x 12.8 mm
