FelixLee43/Mechatronic-2023/机电系统设计实践_张佳悦_2022/作业/第三组智能小车/智能小车3D模型/机械臂/支撑板（改）.SLDPRT

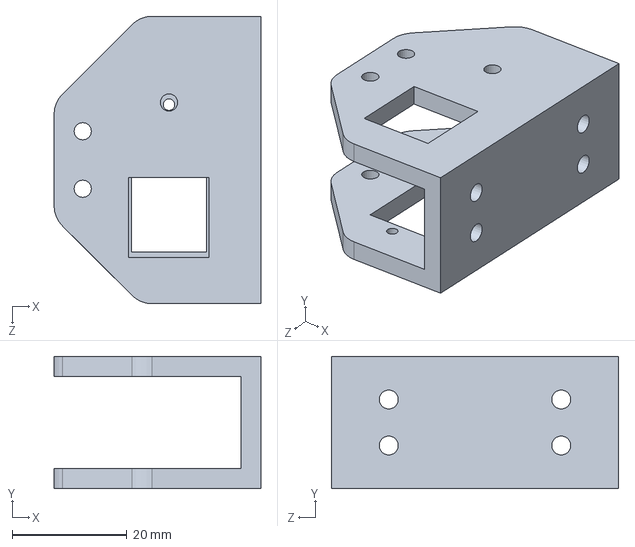
[picture p187: CAD file, 2023-07-10]
机电系统设计实践_张佳悦_2022/作业/第三组智能小车/智能小车3D模型/机械臂/支撑板（改）.SLDPRT
36.0 x 23.0 x 50.0 mm
