FelixLee43/Mechatronic-2023/机电系统设计实践_张佳悦_2022/作业/第三组智能小车/智能小车3D模型/电池壳子.SLDPRT

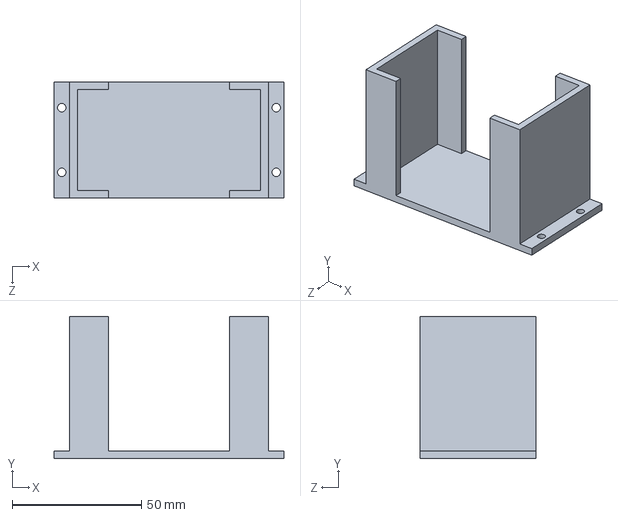
[picture p188: CAD file, 2023-07-10]
机电系统设计实践_张佳悦_2022/作业/第三组智能小车/智能小车3D模型/电池壳子.SLDPRT
89.0 x 55.0 x 45.0 mm
