FelixLee43/Mechatronic-2023/机电系统设计实践_张佳悦_2022/作业/第三组详细设计/智能小车3D模型/OpenMV H7/C0603K_C0603K.SLDPRT

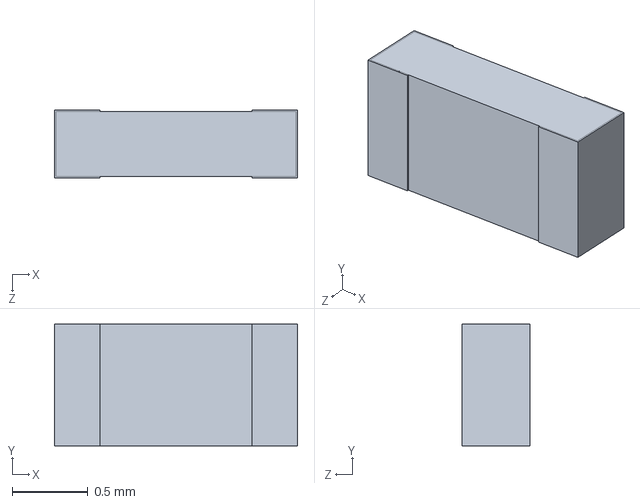
[picture p189: CAD file, 2023-07-10]
机电系统设计实践_张佳悦_2022/作业/第三组详细设计/智能小车3D模型/OpenMV H7/C0603K_C0603K.SLDPRT
1.60 x 0.8 x 0.45 mm
