FelixLee43/Mechatronic-2023/机电系统设计实践_张佳悦_2022/作业/第三组智能小车/智能小车3D模型/OpenMV H7/SOT 23-5.SLDPRT

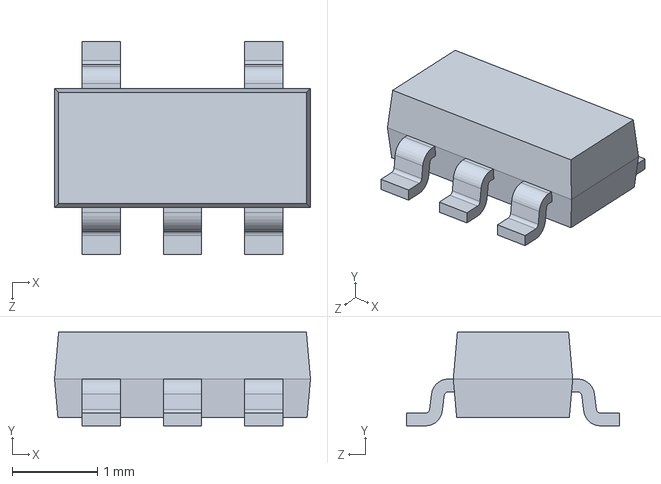
[picture p190: CAD file, 2023-07-10]
机电系统设计实践_张佳悦_2022/作业/第三组智能小车/智能小车3D模型/OpenMV H7/SOT 23-5.SLDPRT
3.00 x 1.10 x 2.50 mm
