FelixLee43/Mechatronic-2023/机电系统设计实践_张佳悦_2022/作业/第三组智能小车/智能小车3D模型/机械臂/连杆（改）.SLDPRT

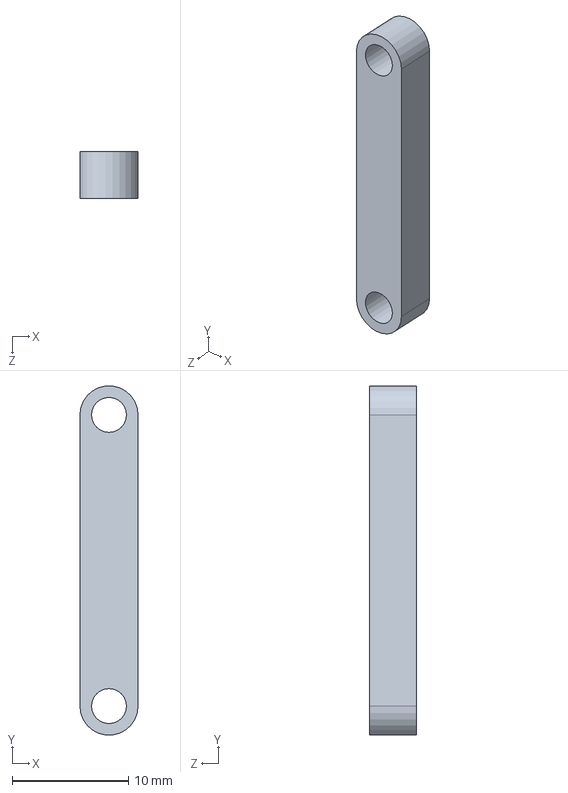
[picture p191: CAD file, 2023-07-10]
机电系统设计实践_张佳悦_2022/作业/第三组智能小车/智能小车3D模型/机械臂/连杆（改）.SLDPRT
5.00 x 30.0 x 4.00 mm
