FelixLee43/Mechatronic-2023/机电系统设计实践_张佳悦_2022/作业/第三组智能小车/智能小车3D模型/第二层.SLDPRT

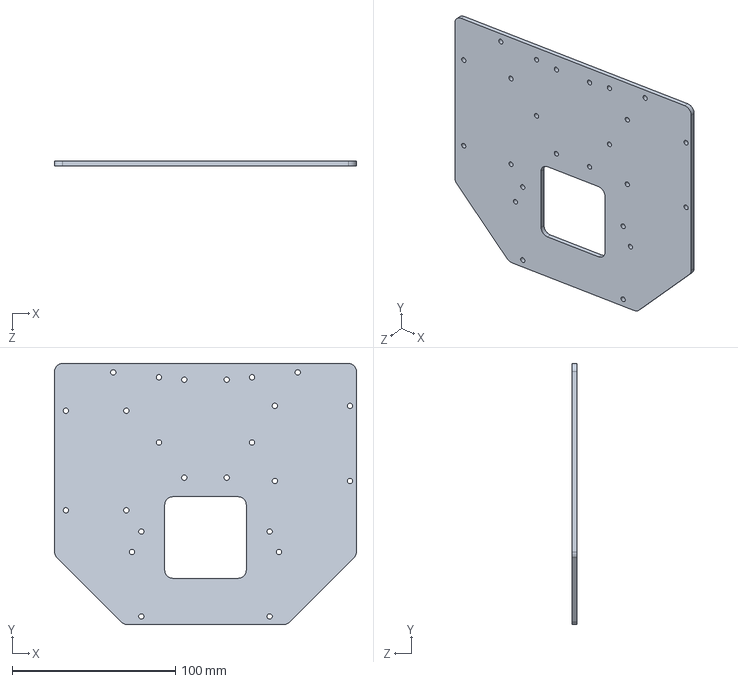
[picture p192: CAD file, 2023-07-10]
机电系统设计实践_张佳悦_2022/作业/第三组智能小车/智能小车3D模型/第二层.SLDPRT
185.0 x 160.0 x 3.00 mm
