FelixLee43/Mechatronic-2023/机电系统设计实践_张佳悦_2022/作业/第三组详细设计/智能小车3D模型/MG995/bracket.SLDPRT

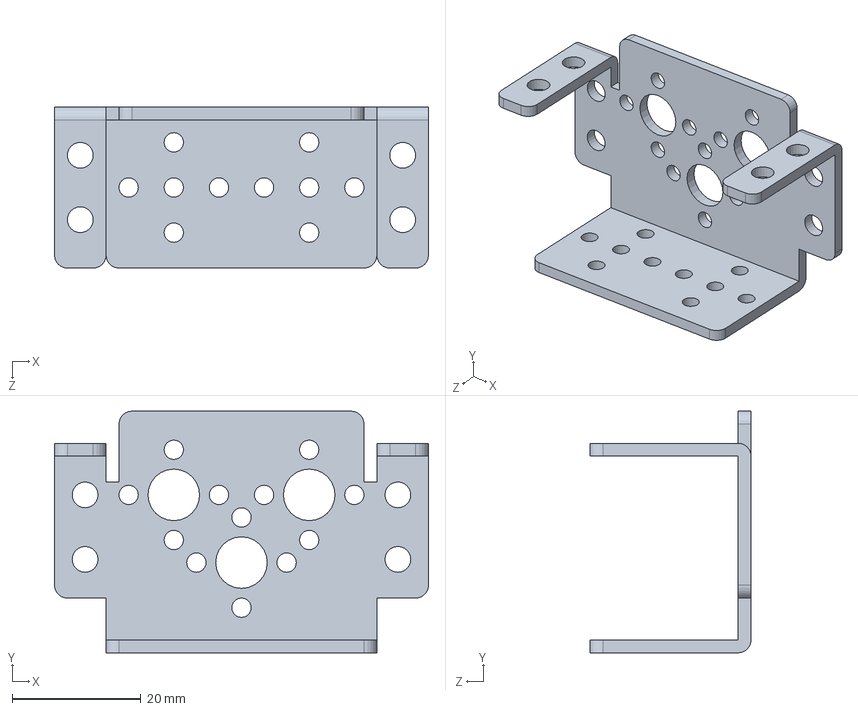
[picture p193: CAD file, 2023-07-10]
机电系统设计实践_张佳悦_2022/作业/第三组详细设计/智能小车3D模型/MG995/bracket.SLDPRT
58.0 x 37.5 x 25.0 mm
