FelixLee43/Mechatronic-2023/机电系统设计实践_张佳悦_2022/作业/第三组智能小车/智能小车3D模型/尾部支架.SLDPRT

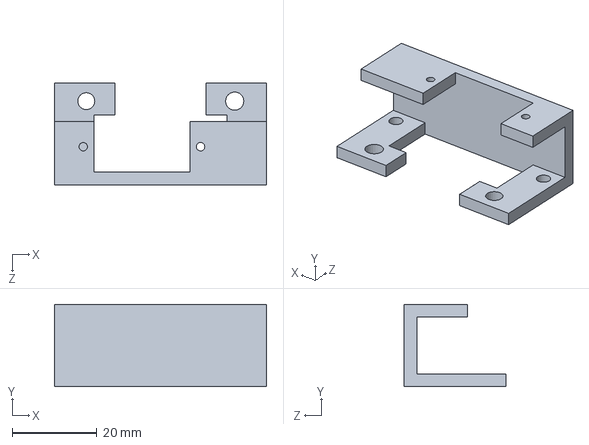
[picture p195: CAD file, 2023-07-10]
机电系统设计实践_张佳悦_2022/作业/第三组智能小车/智能小车3D模型/尾部支架.SLDPRT
50.0 x 19.4 x 24.0 mm
