FelixLee43/Mechatronic-2023/机电系统设计实践_张佳悦_2022/作业/第三组详细设计/智能小车3D模型/机械臂/机械手爪（改）.SLDPRT

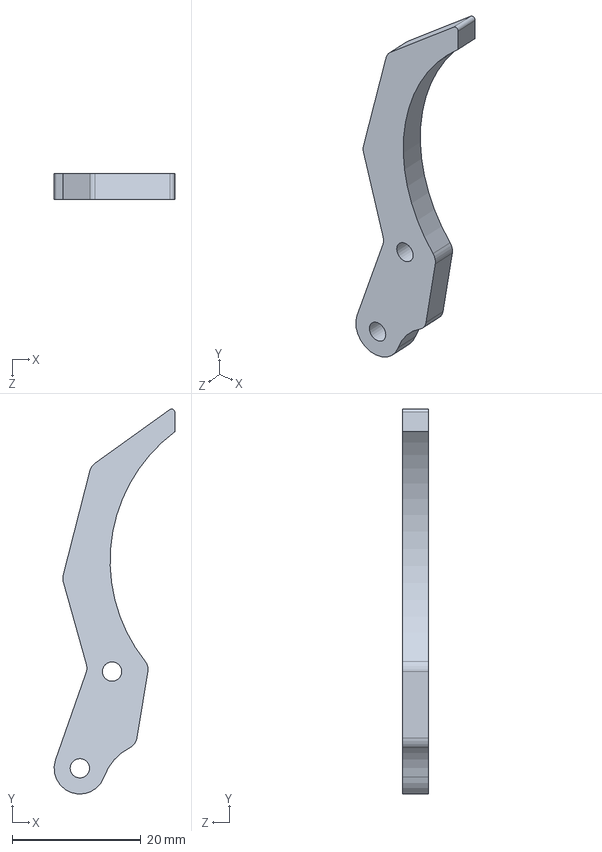
[picture p196: CAD file, 2023-07-10]
机电系统设计实践_张佳悦_2022/作业/第三组详细设计/智能小车3D模型/机械臂/机械手爪（改）.SLDPRT
18.7 x 59.7 x 4.00 mm
