FelixLee43/Mechatronic-2023/机电系统设计实践_张佳悦_2022/作业/第三组智能小车/智能小车3D模型/MG995/egrane3aluminio.SLDPRT

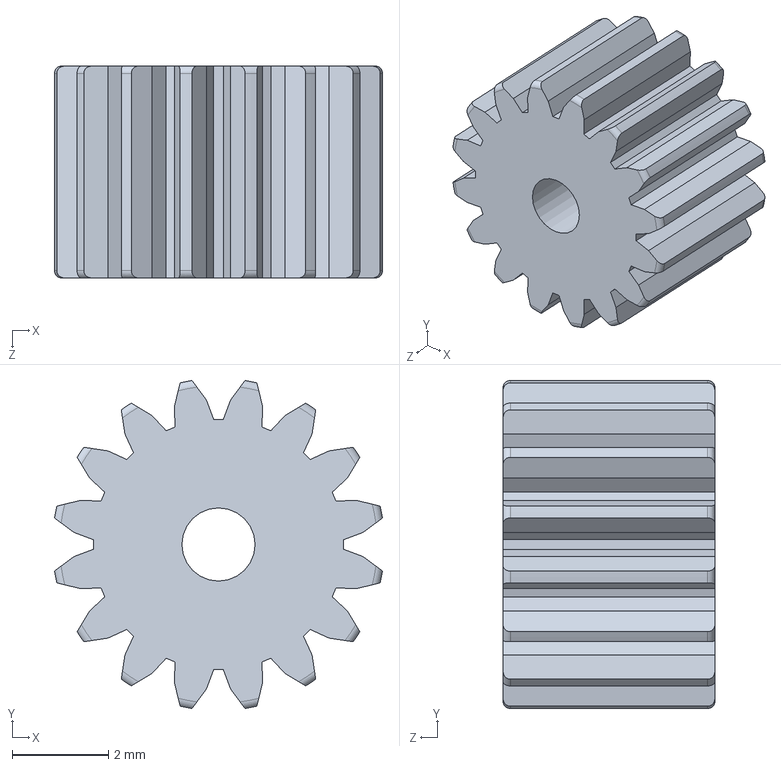
[picture p197: CAD file, 2023-07-10]
机电系统设计实践_张佳悦_2022/作业/第三组智能小车/智能小车3D模型/MG995/egrane3aluminio.SLDPRT
6.81 x 6.81 x 4.40 mm
