FelixLee43/Mechatronic-2023/机电系统设计实践_张佳悦_2022/作业/第三组智能小车/智能小车3D模型/第一层.SLDPRT

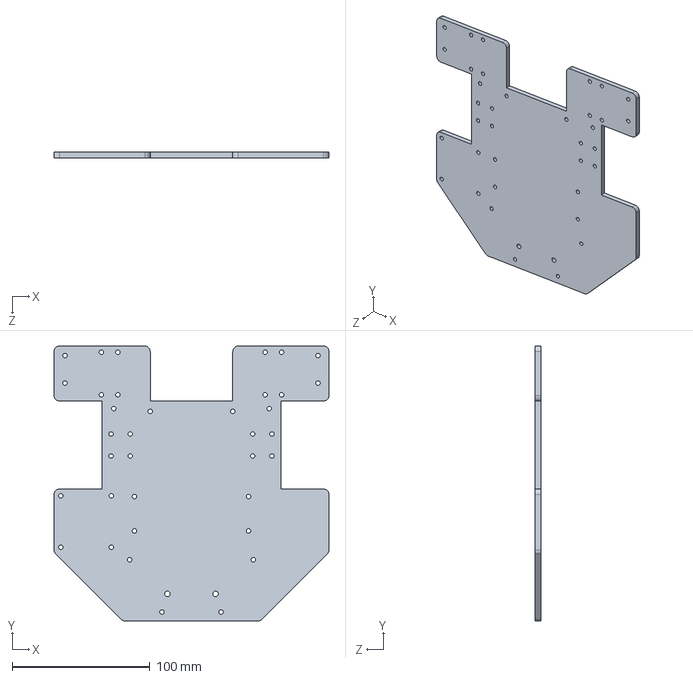
[picture p199: CAD file, 2023-07-10]
机电系统设计实践_张佳悦_2022/作业/第三组智能小车/智能小车3D模型/第一层.SLDPRT
200.0 x 200.0 x 4.00 mm
