FelixLee43/Mechatronic-2023/机电系统设计实践_张佳悦_2022/作业/第三组智能小车/智能小车3D模型/限位尼龙柱.SLDPRT

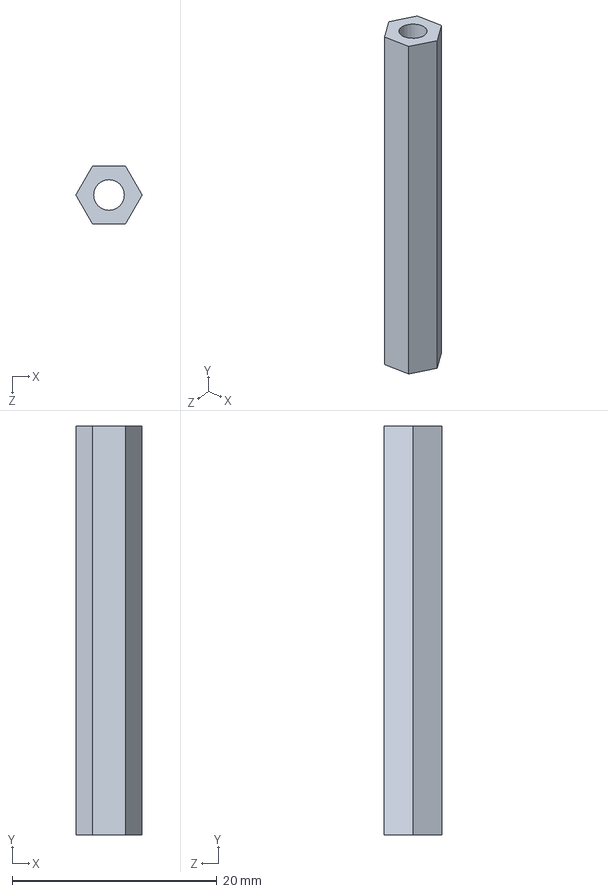
[picture p202: CAD file, 2023-07-10]
机电系统设计实践_张佳悦_2022/作业/第三组智能小车/智能小车3D模型/限位尼龙柱.SLDPRT
6.50 x 40.0 x 5.63 mm
