FelixLee43/Mechatronic-2023/机电系统设计实践_张佳悦_2022/作业/第三组智能小车/智能小车3D模型/OpenMV H7/C0805K_C0805K.SLDPRT

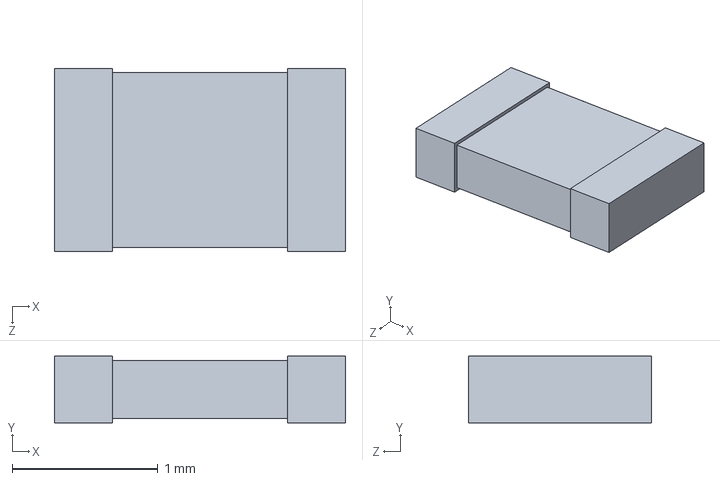
[picture p206: CAD file, 2023-07-10]
机电系统设计实践_张佳悦_2022/作业/第三组智能小车/智能小车3D模型/OpenMV H7/C0805K_C0805K.SLDPRT
2.00 x 0.46 x 1.26 mm
