FelixLee43/Mechatronic-2023/机电系统设计实践_张佳悦_2022/作业/第三组详细设计/智能小车3D模型/OpenMV H7/LED SMD RGB.SLDPRT

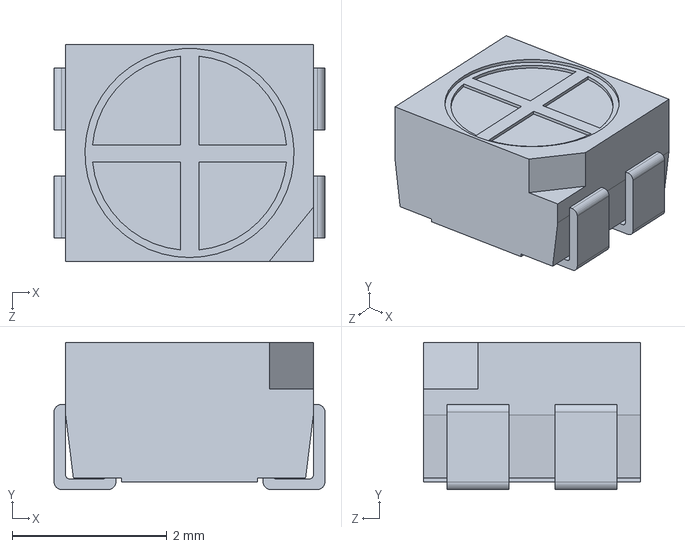
[picture p212: CAD file, 2023-07-10]
机电系统设计实践_张佳悦_2022/作业/第三组详细设计/智能小车3D模型/OpenMV H7/LED SMD RGB.SLDPRT
3.50 x 1.90 x 2.80 mm
