FelixLee43/Mechatronic-2023/机电系统设计实践_张佳悦_2022/作业/第三组智能小车/智能小车3D模型/摄像头支撑架.SLDPRT

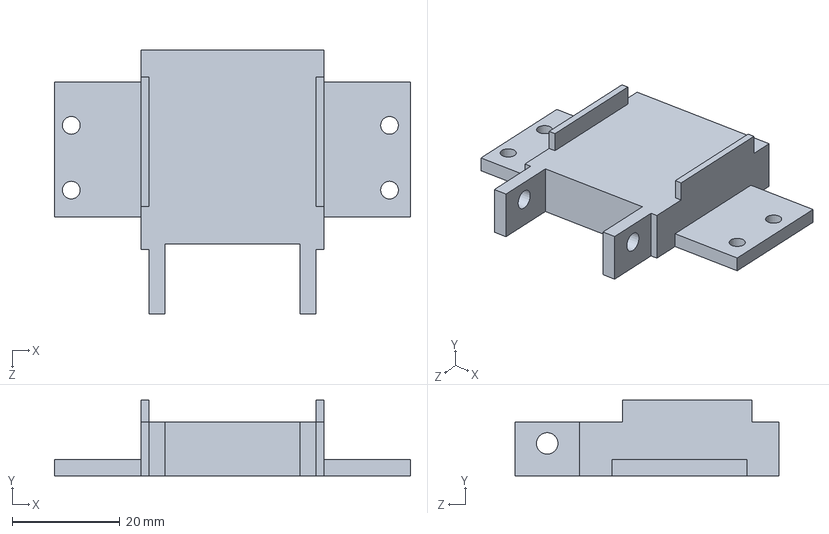
[picture p214: CAD file, 2023-07-10]
机电系统设计实践_张佳悦_2022/作业/第三组智能小车/智能小车3D模型/摄像头支撑架.SLDPRT
66.0 x 14.0 x 49.0 mm
