FelixLee43/Mechatronic-2023/机电系统设计实践_张佳悦_2022/作业/第三组智能小车/智能小车3D模型/HC-SR04支撑架（前）.SLDPRT

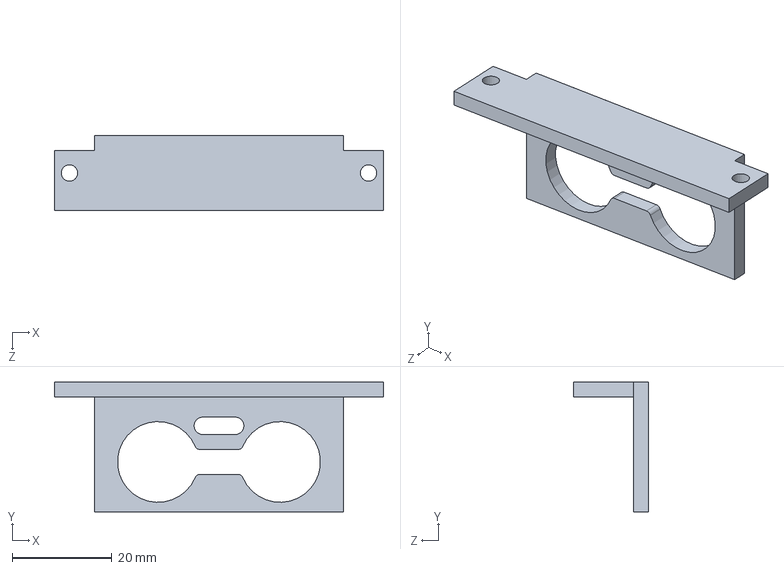
[picture p215: CAD file, 2023-07-10]
机电系统设计实践_张佳悦_2022/作业/第三组智能小车/智能小车3D模型/HC-SR04支撑架（前）.SLDPRT
66.0 x 26.0 x 15.0 mm
