FelixLee43/Mechatronic-2023/机电系统设计实践_张佳悦_2022/作业/第三组详细设计/智能小车3D模型/OpenMV H7/Micro USB connector angle.SLDPRT

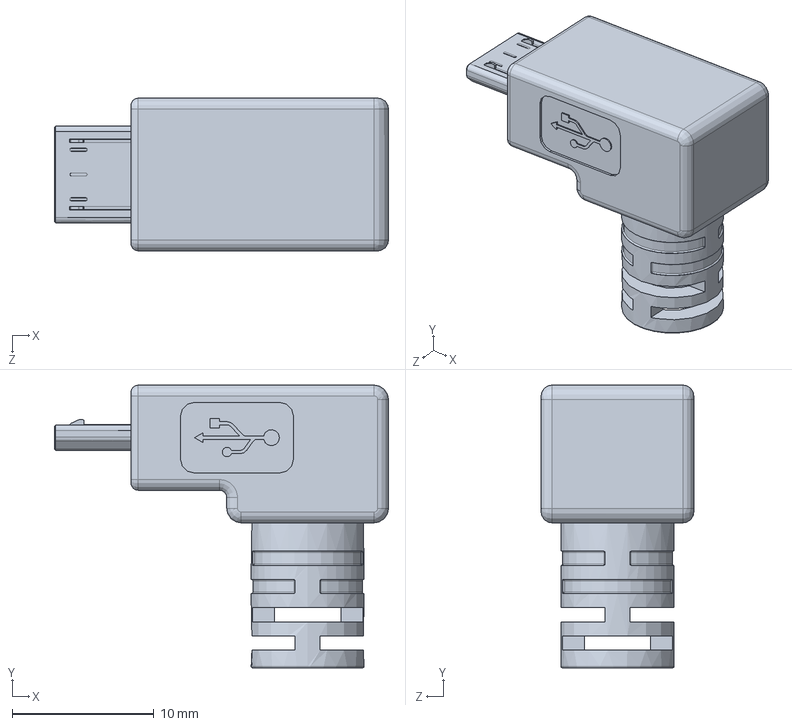
[picture p216: CAD file, 2023-07-10]
机电系统设计实践_张佳悦_2022/作业/第三组详细设计/智能小车3D模型/OpenMV H7/Micro USB connector angle.SLDPRT
23.6 x 20.0 x 10.8 mm
