FelixLee43/Mechatronic-2023/机电系统设计实践_张佳悦_2022/作业/第三组详细设计/智能小车3D模型/电池组.SLDPRT

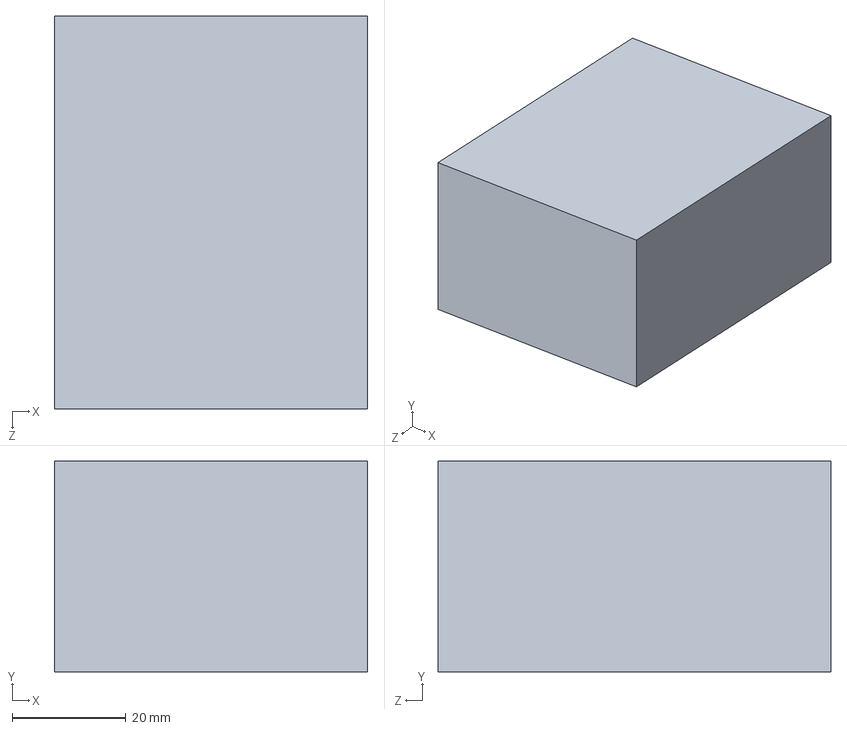
[picture p217: CAD file, 2023-07-10]
机电系统设计实践_张佳悦_2022/作业/第三组详细设计/智能小车3D模型/电池组.SLDPRT
55.0 x 37.0 x 69.0 mm
