FelixLee43/Mechatronic-2023/机电系统设计实践_张佳悦_2022/作业/第三组智能小车/智能小车3D模型/OpenMV H7/UJ2-MIBH2-4-SMT_02.SLDPRT

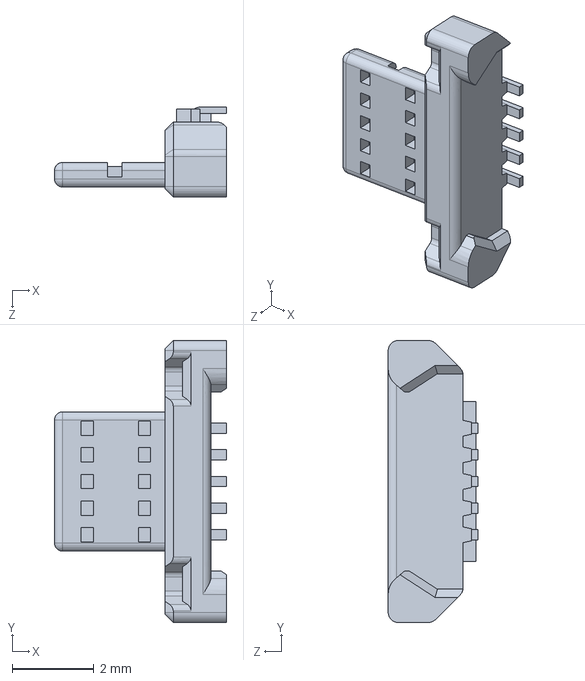
[picture p218: CAD file, 2023-07-10]
机电系统设计实践_张佳悦_2022/作业/第三组智能小车/智能小车3D模型/OpenMV H7/UJ2-MIBH2-4-SMT_02.SLDPRT
4.20 x 6.88 x 2.19 mm
