FelixLee43/Mechatronic-2023/(list of files, cad)

Other CAD files:
机电系统设计实践_张佳悦_2022/作业/第三组智能小车/智能小车3D模型/L298N/L298N.SLDASM
机电系统设计实践_张佳悦_2022/作业/第三组详细设计/智能小车3D模型/MG995/MG995.SLDASM
机电系统设计实践_张佳悦_2022/作业/第三组详细设计/智能小车3D模型/OpenMV H7/OpenMV H7.SLDASM
机电系统设计实践_张佳悦_2022/作业/第三组智能小车/智能小车3D模型/SG90/Tower Pro 9g Micro Servo SG90.SLDPRT
机电系统设计实践_张佳悦_2022/作业/第三组详细设计/上层板.dwg
机电系统设计实践_张佳悦_2022/作业/第三组详细设计/智能小车3D模型/L298N/L298N Stepper Motor Driver (Red).SLDPRT
机电系统设计实践_张佳悦_2022/作业/第三组详细设计/智能小车3D模型/SG90/Tower Pro 9g Micro Servo SG90.SLDPRT
智能小车/普通轮/电机架.SLDPRT
机电系统设计实践_张佳悦_2022/作业/第三组智能小车/智能小车3D模型/L298N/L298N Stepper Motor Driver (Red).SLDPRT
机电系统设计实践_张佳悦_2022/作业/第三组智能小车/智能小车3D模型/OpenMV H7/User Library-LQFP100-3_case.sldprt
机电系统设计实践_张佳悦_2022/作业/第三组智能小车/智能小车3D模型/车轮/25GA370.SLDPRT
机电系统设计实践_张佳悦_2022/作业/第三组智能小车/智能小车3D模型/镜向HC-SR04支撑架（右前）新.SLDPRT
机电系统设计实践_张佳悦_2022/作业/第三组详细设计/下层板.dwg
机电系统设计实践_张佳悦_2022/作业/第三组智能小车/智能小车3D模型/车轮/橡胶车轮.SLDPRT
机电系统设计实践_张佳悦_2022/作业/第三组详细设计/智能小车3D模型/车轮/橡胶车轮.SLDPRT
机电系统设计实践_张佳悦_2022/作业/第三组详细设计/智能小车3D模型/机械臂/齿轮传动杆.SLDPRT
机电系统设计实践_张佳悦_2022/作业/第三组详细设计/智能小车3D模型/车轮/25GA370.SLDPRT
机电系统设计实践_张佳悦_2022/作业/第三组详细设计/智能小车3D模型/镜向HC-SR04支撑架（右前）新.SLDPRT
机电系统设计实践_张佳悦_2022/作业/第三组详细设计/智能小车3D模型/机械臂/连杆（改）.SLDPRT
机电系统设计实践_张佳悦_2022/作业/第三组详细设计/智能小车3D模型/第二层.SLDPRT
机电系统设计实践_张佳悦_2022/作业/第三组详细设计/智能小车3D模型/MG995/tapa servo.SLDPRT
机电系统设计实践_张佳悦_2022/作业/第三组详细设计/智能小车3D模型/OpenMV H7/User Library-LQFP100-3_pin.sldprt
机电系统设计实践_张佳悦_2022/作业/第三组详细设计/智能小车3D模型/机械臂支架.SLDPRT
机电系统设计实践_张佳悦_2022/作业/第三组详细设计/智能小车3D模型/HY-SRF05.SLDPRT
机电系统设计实践_张佳悦_2022/作业/第三组智能小车/智能小车3D模型/OpenMV H7/R0603_SJR.SLDPRT
机电系统设计实践_张佳悦_2022/作业/第三组智能小车/智能小车3D模型/MG995/egrane2laton.SLDPRT
机电系统设计实践_张佳悦_2022/作业/第三组详细设计/智能小车3D模型/MG995/egrane2laton.SLDPRT
机电系统设计实践_张佳悦_2022/作业/第三组智能小车/智能小车3D模型/OpenMV H7/User Library-LQFP100-3_pin.sldprt
智能小车/二楼/二楼支撑柱.DWG
智能小车/底板/底板.DWG
智能小车/抓手/俯仰部分.DWG
智能小车/抓手/俯仰部分右固定座.DWG
智能小车/抓手/俯仰部分左固定座.DWG
智能小车/抓手/抓手齿轮盒.DWG
智能小车/普通轮/普通轮.DWG
智能小车/普通轮/电机.DWG
智能小车/普通轮/电机架.DWG
智能小车/牛眼轮/牛眼轮.DWG
智能小车/超声/超声波探测器.DWG
机电系统设计实践_张佳悦_2022/作业/第三组智能小车/智能小车3D模型/HC-SR04.SLDPRT
机电系统设计实践_张佳悦_2022/作业/第三组智能小车/智能小车3D模型/HC-SR04支撑架（右前）新.SLDPRT
机电系统设计实践_张佳悦_2022/作业/第三组智能小车/智能小车3D模型/HC-SR04支撑架（尾）.SLDPRT
机电系统设计实践_张佳悦_2022/作业/第三组智能小车/智能小车3D模型/L298N/L298N.SLDPRT
机电系统设计实践_张佳悦_2022/作业/第三组智能小车/智能小车3D模型/LM2596S电源模块.SLDPRT
机电系统设计实践_张佳悦_2022/作业/第三组智能小车/智能小车3D模型/MG995/baseservo.SLDPRT
机电系统设计实践_张佳悦_2022/作业/第三组智能小车/智能小车3D模型/OpenMV H7/0805.SLDPRT
机电系统设计实践_张佳悦_2022/作业/第三组智能小车/智能小车3D模型/OpenMV H7/1040310811_USD1040310811.sldprt
机电系统设计实践_张佳悦_2022/作业/第三组智能小车/智能小车3D模型/OpenMV H7/960240-6202-AR 1x6 long.SLDASM
机电系统设计实践_张佳悦_2022/作业/第三组智能小车/智能小车3D模型/OpenMV H7/960240-6202-AR 1x8 long.SLDASM
机电系统设计实践_张佳悦_2022/作业/第三组智能小车/智能小车3D模型/OpenMV H7/960240-6202-AR Body6.SLDPRT
机电系统设计实践_张佳悦_2022/作业/第三组智能小车/智能小车3D模型/OpenMV H7/960240-6202-AR Body8.SLDPRT
机电系统设计实践_张佳悦_2022/作业/第三组智能小车/智能小车3D模型/OpenMV H7/960240-6202-AR Pin Long.SLDPRT
机电系统设计实践_张佳悦_2022/作业/第三组智能小车/智能小车3D模型/OpenMV H7/Crystal-SM2520-4.SLDPRT
机电系统设计实践_张佳悦_2022/作业/第三组智能小车/智能小车3D模型/OpenMV H7/DF1236.SLDPRT
机电系统设计实践_张佳悦_2022/作业/第三组智能小车/智能小车3D模型/OpenMV H7/LED 1206 IR.SLDPRT
机电系统设计实践_张佳悦_2022/作业/第三组智能小车/智能小车3D模型/OpenMV H7/LENS_Standard.SLDPRT
机电系统设计实践_张佳悦_2022/作业/第三组智能小车/智能小车3D模型/OpenMV H7/Micro USB connector.SLDPRT
机电系统设计实践_张佳悦_2022/作业/第三组智能小车/智能小车3D模型/OpenMV H7/S2B-PH-K-S(LF)(SN).SLDPRT
机电系统设计实践_张佳悦_2022/作业/第三组智能小车/智能小车3D模型/OpenMV H7/SOD323_BAT54HT1G.SLDPRT
机电系统设计实践_张佳悦_2022/作业/第三组智能小车/智能小车3D模型/OpenMV H7/SOT 23.SLDPRT
机电系统设计实践_张佳悦_2022/作业/第三组智能小车/智能小车3D模型/OpenMV H7/UJ2-MIBH2-4-SMT_01.SLDPRT
机电系统设计实践_张佳悦_2022/作业/第三组智能小车/智能小车3D模型/OpenMV H7/User Library-LQFP100-3_circle.sldprt
机电系统设计实践_张佳悦_2022/作业/第三组智能小车/智能小车3D模型/OpenMV H7/base.sldprt
机电系统设计实践_张佳悦_2022/作业/第三组智能小车/智能小车3D模型/OpenMV H7/cap3216h160.SLDPRT
机电系统设计实践_张佳悦_2022/作业/第三组智能小车/智能小车3D模型/OpenMV H7/microsd card.SLDPRT
机电系统设计实践_张佳悦_2022/作业/第三组智能小车/智能小车3D模型/OpenMV H7/mount_lens.SLDPRT
机电系统设计实践_张佳悦_2022/作业/第三组智能小车/智能小车3D模型/OpenMV H7/pan head cross recess screw_iso.sldprt
机电系统设计实践_张佳悦_2022/作业/第三组智能小车/智能小车3D模型/OpenMV 支撑架.SLDPRT
机电系统设计实践_张佳悦_2022/作业/第三组智能小车/智能小车3D模型/STM32F103VET6开发板.SLDPRT
机电系统设计实践_张佳悦_2022/作业/第三组智能小车/智能小车3D模型/二层三层连接件.SLDPRT
机电系统设计实践_张佳悦_2022/作业/第三组智能小车/智能小车3D模型/二层三层连接件2.SLDPRT
机电系统设计实践_张佳悦_2022/作业/第三组智能小车/智能小车3D模型/天线.SLDPRT
机电系统设计实践_张佳悦_2022/作业/第三组智能小车/智能小车3D模型/摄像头.SLDPRT
机电系统设计实践_张佳悦_2022/作业/第三组智能小车/智能小车3D模型/摄像头底座.SLDPRT
机电系统设计实践_张佳悦_2022/作业/第三组智能小车/智能小车3D模型/机械臂支架.SLDPRT
机电系统设计实践_张佳悦_2022/作业/第三组智能小车/智能小车3D模型/机械臂转轴.SLDPRT
机电系统设计实践_张佳悦_2022/作业/第三组智能小车/智能小车3D模型/牛眼轮/牛眼轮.SLDASM
机电系统设计实践_张佳悦_2022/作业/第三组智能小车/智能小车3D模型/牛眼轮/牛眼轮心.SLDPRT
机电系统设计实践_张佳悦_2022/作业/第三组智能小车/智能小车3D模型/牛眼轮/牛眼轮框.SLDPRT
机电系统设计实践_张佳悦_2022/作业/第三组智能小车/智能小车3D模型/第三层.SLDPRT
机电系统设计实践_张佳悦_2022/作业/第三组智能小车/智能小车3D模型/面包板.SLDPRT
机电系统设计实践_张佳悦_2022/作业/第三组智能小车/智能小车3D模型/面包板支架.SLDPRT
机电系统设计实践_张佳悦_2022/作业/第三组详细设计/智能小车3D模型/HC-SR04支撑架（前）.SLDPRT
机电系统设计实践_张佳悦_2022/作业/第三组详细设计/智能小车3D模型/HC-SR04支撑架（尾）.SLDPRT
机电系统设计实践_张佳悦_2022/作业/第三组详细设计/智能小车3D模型/L298N/L298N.SLDPRT
机电系统设计实践_张佳悦_2022/作业/第三组详细设计/智能小车3D模型/LM2596S电源模块.SLDPRT
机电系统设计实践_张佳悦_2022/作业/第三组详细设计/智能小车3D模型/MG995/baseservo.SLDPRT
机电系统设计实践_张佳悦_2022/作业/第三组详细设计/智能小车3D模型/OpenMV H7/0805.SLDPRT
机电系统设计实践_张佳悦_2022/作业/第三组详细设计/智能小车3D模型/OpenMV H7/1040310811_USD1040310811.sldprt
机电系统设计实践_张佳悦_2022/作业/第三组详细设计/智能小车3D模型/OpenMV H7/960240-6202-AR 1x6 long.SLDASM
机电系统设计实践_张佳悦_2022/作业/第三组详细设计/智能小车3D模型/OpenMV H7/960240-6202-AR 1x8 long.SLDASM
机电系统设计实践_张佳悦_2022/作业/第三组详细设计/智能小车3D模型/OpenMV H7/960240-6202-AR Body6.SLDPRT
机电系统设计实践_张佳悦_2022/作业/第三组详细设计/智能小车3D模型/OpenMV H7/960240-6202-AR Body8.SLDPRT
机电系统设计实践_张佳悦_2022/作业/第三组详细设计/智能小车3D模型/OpenMV H7/960240-6202-AR Pin Long.SLDPRT
机电系统设计实践_张佳悦_2022/作业/第三组详细设计/智能小车3D模型/OpenMV H7/Crystal-SM2520-4.SLDPRT
机电系统设计实践_张佳悦_2022/作业/第三组详细设计/智能小车3D模型/OpenMV H7/DF1236.SLDPRT
机电系统设计实践_张佳悦_2022/作业/第三组详细设计/智能小车3D模型/OpenMV H7/LED 1206 IR.SLDPRT
机电系统设计实践_张佳悦_2022/作业/第三组详细设计/智能小车3D模型/OpenMV H7/LENS_Standard.SLDPRT
机电系统设计实践_张佳悦_2022/作业/第三组详细设计/智能小车3D模型/OpenMV H7/Micro USB connector.SLDPRT
机电系统设计实践_张佳悦_2022/作业/第三组详细设计/智能小车3D模型/OpenMV H7/R0603_SJR.SLDPRT
机电系统设计实践_张佳悦_2022/作业/第三组详细设计/智能小车3D模型/OpenMV H7/S2B-PH-K-S(LF)(SN).SLDPRT
机电系统设计实践_张佳悦_2022/作业/第三组详细设计/智能小车3D模型/OpenMV H7/SOD323_BAT54HT1G.SLDPRT
机电系统设计实践_张佳悦_2022/作业/第三组详细设计/智能小车3D模型/OpenMV H7/SOT 23.SLDPRT
机电系统设计实践_张佳悦_2022/作业/第三组详细设计/智能小车3D模型/OpenMV H7/UJ2-MIBH2-4-SMT_01.SLDPRT
机电系统设计实践_张佳悦_2022/作业/第三组详细设计/智能小车3D模型/OpenMV H7/User Library-LQFP100-3_case.sldprt
机电系统设计实践_张佳悦_2022/作业/第三组详细设计/智能小车3D模型/OpenMV H7/User Library-LQFP100-3_circle.sldprt
机电系统设计实践_张佳悦_2022/作业/第三组详细设计/智能小车3D模型/OpenMV H7/base.sldprt
机电系统设计实践_张佳悦_2022/作业/第三组详细设计/智能小车3D模型/OpenMV H7/cap3216h160.SLDPRT
机电系统设计实践_张佳悦_2022/作业/第三组详细设计/智能小车3D模型/OpenMV H7/microsd card.SLDPRT
机电系统设计实践_张佳悦_2022/作业/第三组详细设计/智能小车3D模型/OpenMV H7/mount_lens.SLDPRT
机电系统设计实践_张佳悦_2022/作业/第三组详细设计/智能小车3D模型/OpenMV H7/pan head cross recess screw_iso.sldprt
机电系统设计实践_张佳悦_2022/作业/第三组详细设计/智能小车3D模型/OpenMV 支撑架.SLDPRT
机电系统设计实践_张佳悦_2022/作业/第三组详细设计/智能小车3D模型/STM32F103VET6开发板.SLDPRT
机电系统设计实践_张佳悦_2022/作业/第三组详细设计/智能小车3D模型/二层三层连接件.SLDPRT
机电系统设计实践_张佳悦_2022/作业/第三组详细设计/智能小车3D模型/二层三层连接件2.SLDPRT
机电系统设计实践_张佳悦_2022/作业/第三组详细设计/智能小车3D模型/尾部支架.SLDPRT
机电系统设计实践_张佳悦_2022/作业/第三组详细设计/智能小车3D模型/摄像头.SLDPRT
机电系统设计实践_张佳悦_2022/作业/第三组详细设计/智能小车3D模型/摄像头底座.SLDPRT
机电系统设计实践_张佳悦_2022/作业/第三组详细设计/智能小车3D模型/牛眼轮/牛眼轮.SLDASM
机电系统设计实践_张佳悦_2022/作业/第三组详细设计/智能小车3D模型/牛眼轮/牛眼轮心.SLDPRT
机电系统设计实践_张佳悦_2022/作业/第三组详细设计/智能小车3D模型/牛眼轮/牛眼轮框.SLDPRT
机电系统设计实践_张佳悦_2022/作业/第三组详细设计/智能小车3D模型/第一层.SLDPRT
机电系统设计实践_张佳悦_2022/作业/第三组详细设计/智能小车3D模型/第三层.SLDPRT
机电系统设计实践_张佳悦_2022/作业/第三组详细设计/智能小车3D模型/面包板.SLDPRT
机电系统设计实践_张佳悦_2022/作业/第三组详细设计/智能小车3D模型/面包板支架.SLDPRT
