FelixLee43/Mechatronic-2023/(commit log)

2023-07-10 Add Zhang Jiayue's work
    [00班“机电系统设计实践”分组互评表_张佳悦.xlsx, 0805.SLDPRT, 1040310811_USD1040310811.sldprt, 1206.SLDPRT, 2.1支撑垫片.SLDPRT, 20限位螺栓.SLDPRT, 25GA370.SLDPRT, 25GA370支撑架.SLDPRT]
2023-07-11 Update 机电系统设计实践_张佳悦_2022
2023-07-12 Add 任务分解
