FelixLee43/Mechatronic-2023/(notices)

Notices in the files:
机电系统设计实践_张佳悦_2022/作业/第三组智能小车/项目源代码/intercar/Core/Src/main.c:
© Copyright (c) 2022 STMicroelectronics.
All rights reserved.
This software component is licensed by ST under BSD 3-Clause license,
the "License"; You may not use this file except in compliance with the
License. You may obtain a copy of the License at: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
(C) COPYRIGHT STMicroelectronics *****END OF FILE
